Hojnadel/TD2_Altium/Proyecto/Datasheets/TFT 3.5/pantalla-tactil-tft-lcd-color-35-lector-sd.jpg

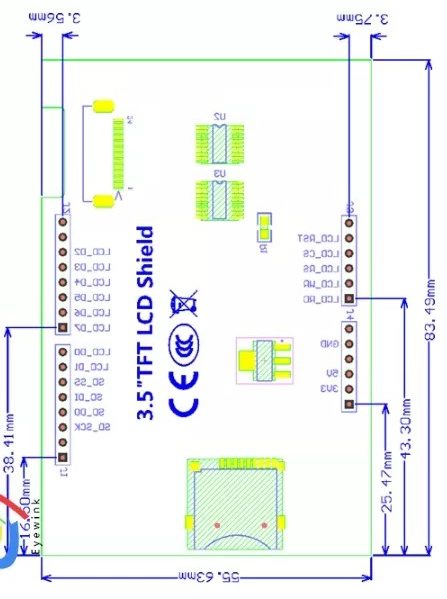
Proyecto/Datasheets/TFT 3.5/pantalla-tactil-tft-lcd-color-35-lector-sd.jpg
