Hojnadel/TD2_Altium/Proyecto/_Fuente Td2/Captura1.JPG

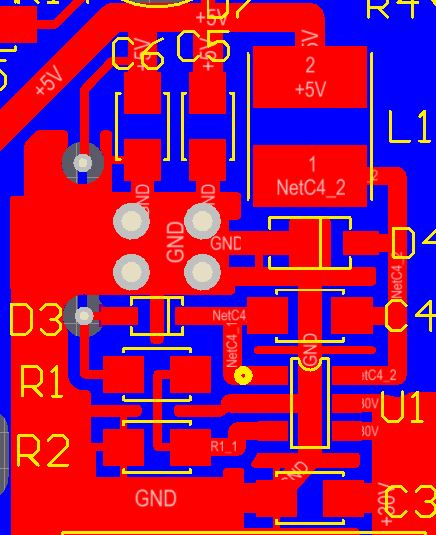
Proyecto/_Fuente Td2/Captura1.JPG
