Hojnadel/TD2_Altium/Proyecto/TDII_Proyecto_G5_Informe_Tecnico.pdf

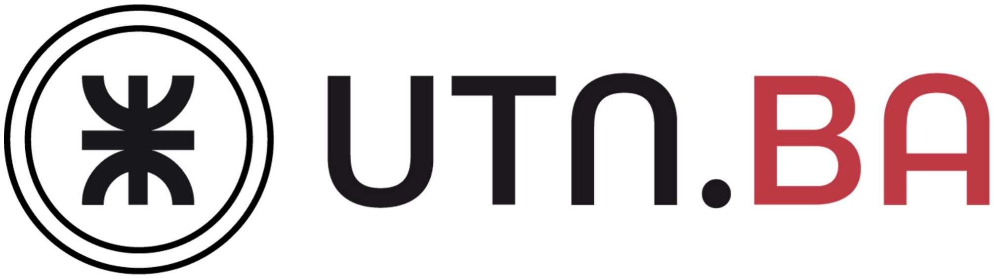
[picture p3: figure]

### Universidad Tecnologica Nacional ´

Facultad Regional Buenos Aires

Departamento de Electronica ´

### Tecnicas Digitales II ´

Proyecto:

## Analizador de Espectro de Audio

## Año 2018

### Grupo No 5:

Integrantes: De Rosa, Mauricio | 140.508-1
Hojnadel, Andrés | 154.563-2

### Salazar Ato, Benjamín Yahir 155.803-1

Soglio, Julián | 141.448-3

### Docentes: Ing. Alarcón, Juan Esteban Ing. Crivelli, Marcelo Alberto

Técnicas Digitales II - Curso: R4051

Técnicas Digitales II
Proyecto: Analizador de Espectro de Audio

Universidad Tecnológica Nacional Facultad Regional Buenos Aires

## Índice

1. Descripción del proyecto | 3
2. Diagrama en bloques | 3
3. Especificaciones técnicas | 4
4. Diagramas esquemáticos | 4
5. Lista de materiales (BOM) | 10
6. PCB: Render 3D | 12
7. Placa soldada | 12
8. Pantalla: ILI9341 | 13
9. Software | 13
9.2.3. Tarea de lectura del teclado: void vTask TecladoRead(void const *) . . . 15
9.2.4. Tarea de resolución del teclado: void vTask TecladoResolve(void const *) 16
10.Gabinete | 17
11.Referencias | 22
Informe Técnico | 2 | Grupo 5

## 1. Descripción del proyecto

El proyecto a diseñar consta de un analizador de espectro de audio el cual podrá adquirir señales ya sea a través su micrófono interno incorporado o cualquier otro dispositivo externo mediante la entrada de audio de 3.5mm para luego realizarles una transformada rápida de Fourier (FFT)[1] y mostrar por pantalla el espectro de la misma en forma continua o en barras de octava. Además cuenta con un conector extra como salida de audio para poder reproducir el audio en el caso de utilizar un dispositivo externo. El ancho de banda a analizar es será de 1Hz a 20kHz.

Internamente consta de cinco bloques: la fuente alimentación, la cual recibe a la entrada una tensión entre 9V y 12V y luego genera 5V y 3V 3 mediante dos fuentes switching; la etapa de adquisición y acondicionamiento de señal, formada por el conector de 3.5mm estereo y el micrófono para la adquisición, y un controlador automático de ganancia (AGC) para el acondicionamiento; un conversor analógico-digital (ADC PCM1802)[2] de 24 bits para realizar el muestreo; el microcontrolador (LPC1769)[3] encargado del procesamiento de la señal y comunicación de los periféricos; el display táctil por el cuál se mostrará la el espectro de la señal y que además funcionará como dispositivo de entrada para las configuraciones menores del dispositivo.

Como la alimentación es con fuente simple (no maneja tensiones negativas) en el acondicionamiento de señal se le agrega una tensión de offset de 2,5 V tal que pueda excursionar de manera simétrica entre 0 V y 5 V . Para ello, luego del levantamiento en continua, se utilizan amplificadores rail-to-rail para poder generar tensiones de salida de tensión similar a su alimentación.

## 2. Diagrama en bloques

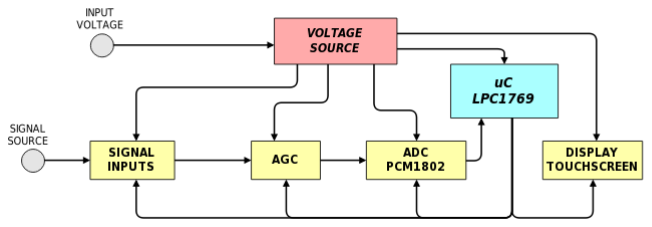
[picture p4: figure]

Figura 1: Diagrama en bloques

Informe Técnico | 3 | Grupo 5

## 3. Especificaciones técnicas

Tensión de alimentación: 9V ∼ 12V

Amplitud máxima de señal: 1,5Vpp

Ancho de banda: 20kHz

Display: TFT LCD Touchscreen 3.2”

## 4. Diagramas esquemáticos

Todos los diagramas esquemáticos del dispositivo y el diseño del PCB fue realizado mediante el software Altium[4].

### 4.1. Estructura jerárquica

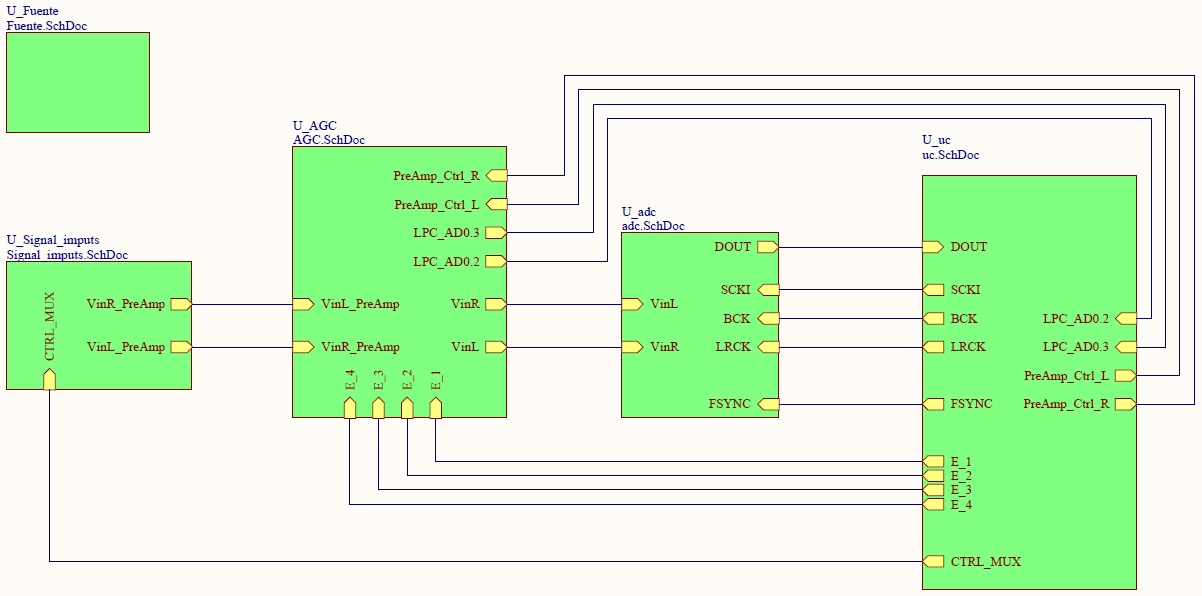
[picture p5: figure]

Figura 2: Estructura jerárquica

Informe Técnico | 4 | Grupo 5

### 4.2. Fuente de alimentación

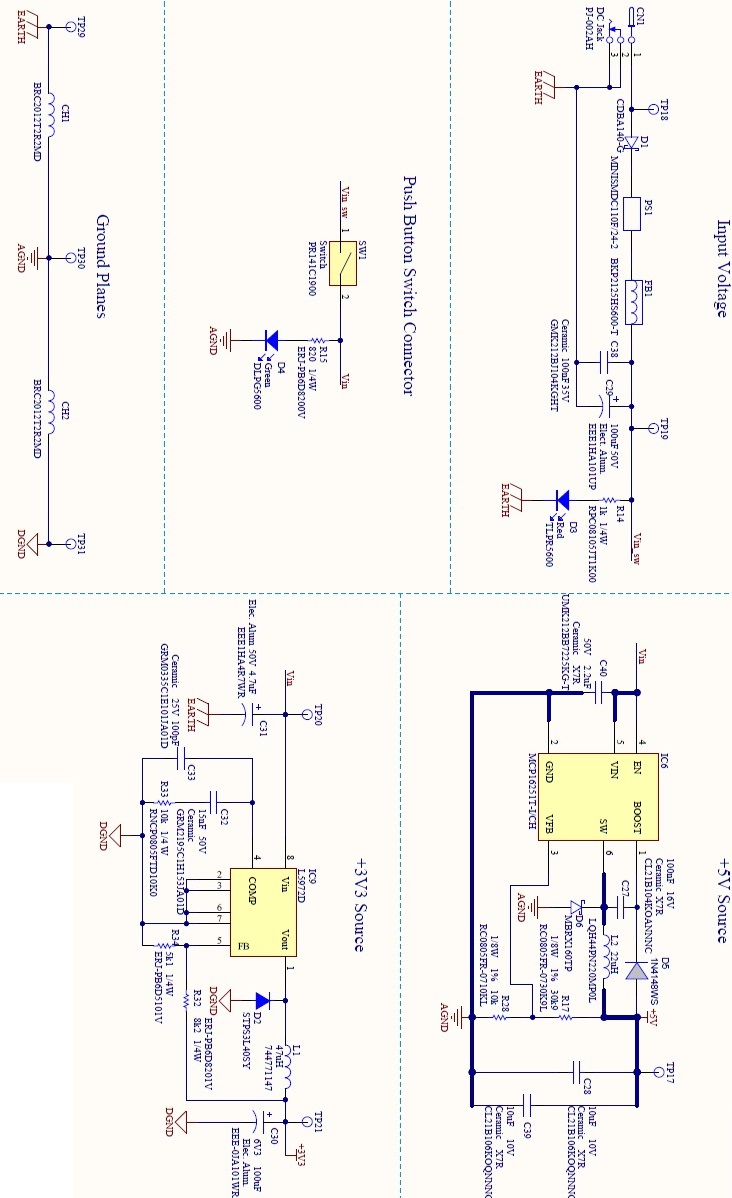
[picture p6: figure]

Figura 3: Esquemático de la fuente de alimentación

Informe Técnico | 5 | Grupo 5

### 4.3. Entrada de señal

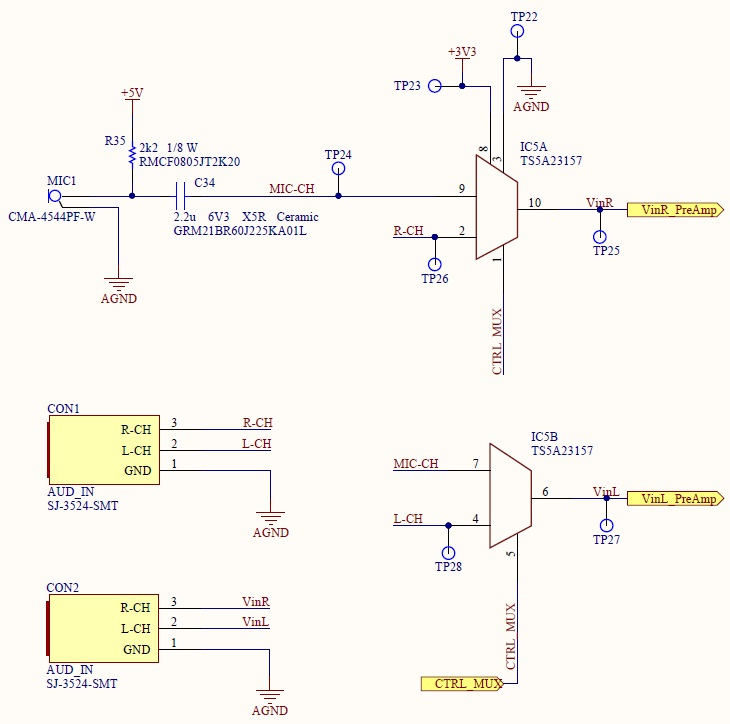
[picture p7: figure]

Figura 4: Esquemático de las entradas de señal

Informe Técnico | 6 | Grupo 5

### 4.4. Control Automático de Ganancia

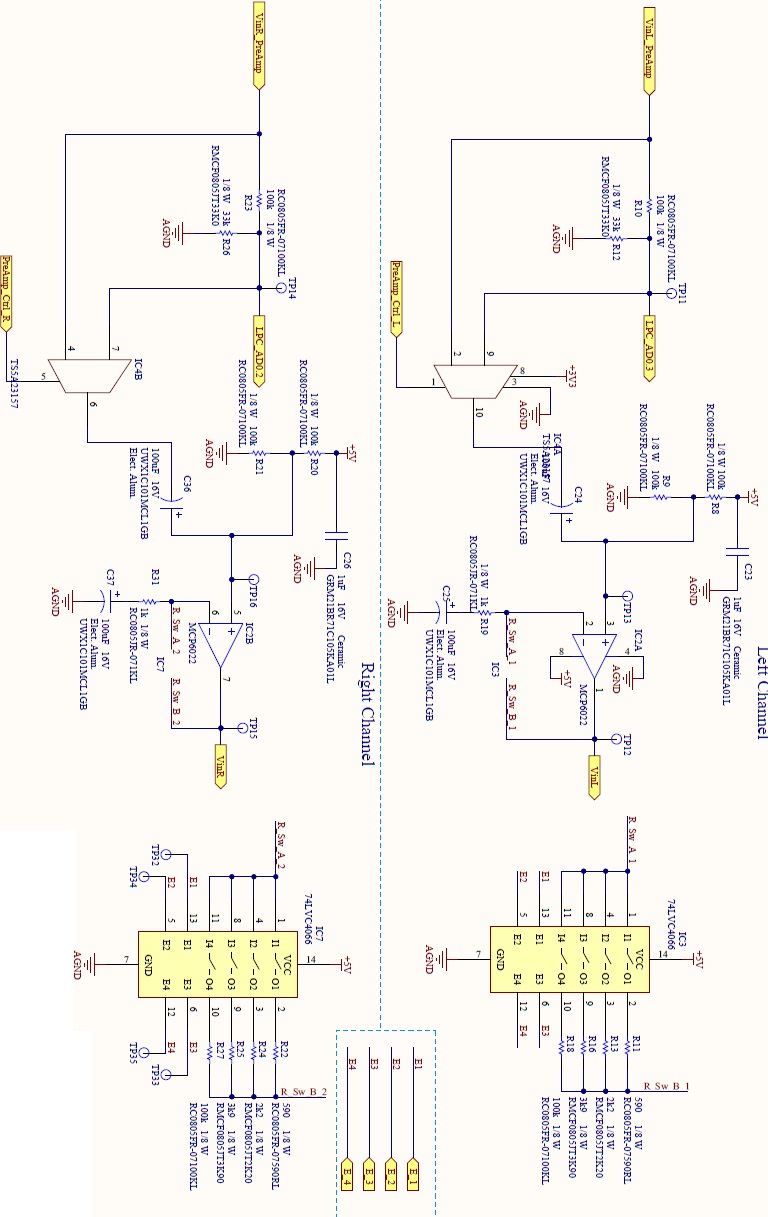
[picture p8: figure]

Figura 5: Esquemático del AGC

Informe Técnico | 7 | Grupo 5

### 4.5. ADC

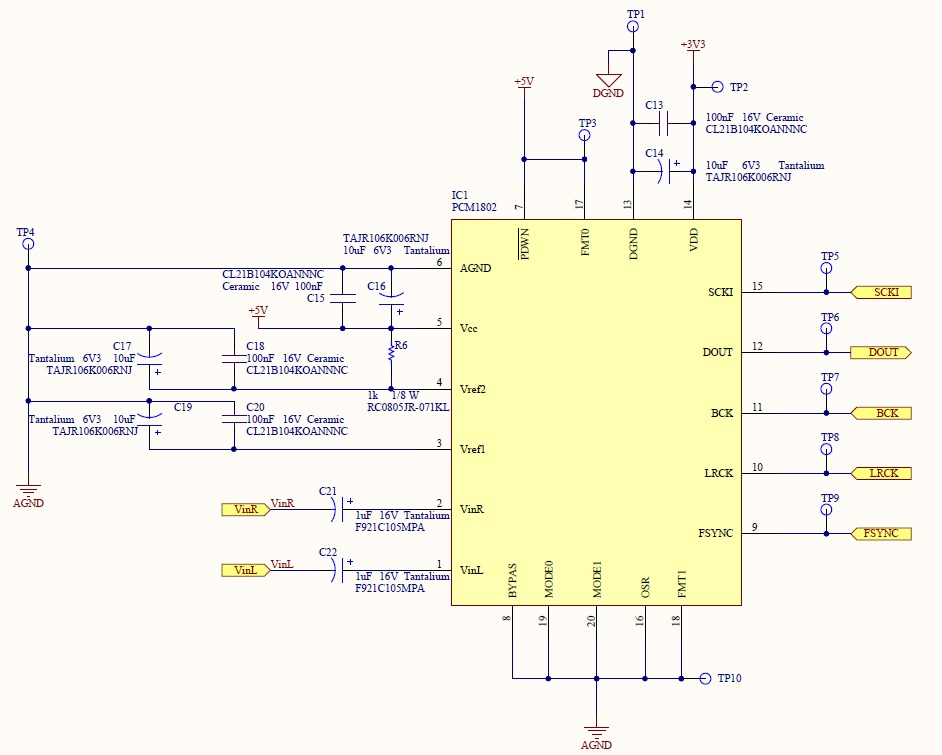
[picture p9: figure]

Figura 6: Esquemático del ADC

Informe Técnico | 8 | Grupo 5

### 4.6. µC

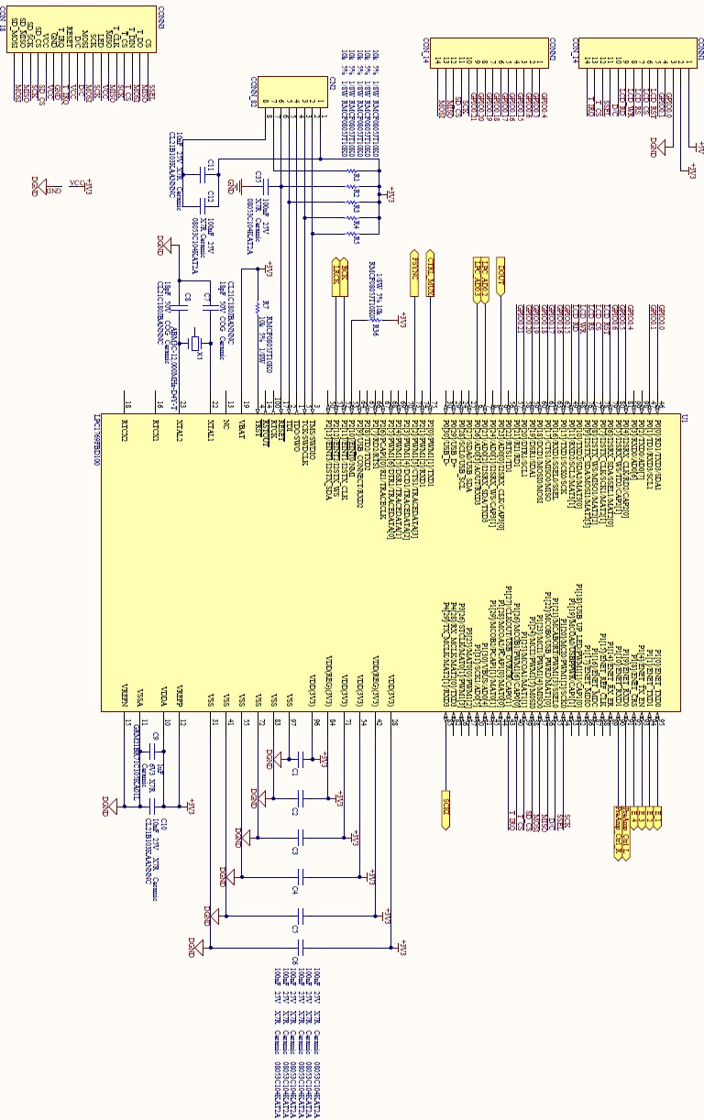
[picture p10: figure]

Figura 7: Esquemático del microcontrolador

Informe Técnico | 9 | Grupo 5

## 5. Lista de materiales (BOM)

### 5.1. Parte 1

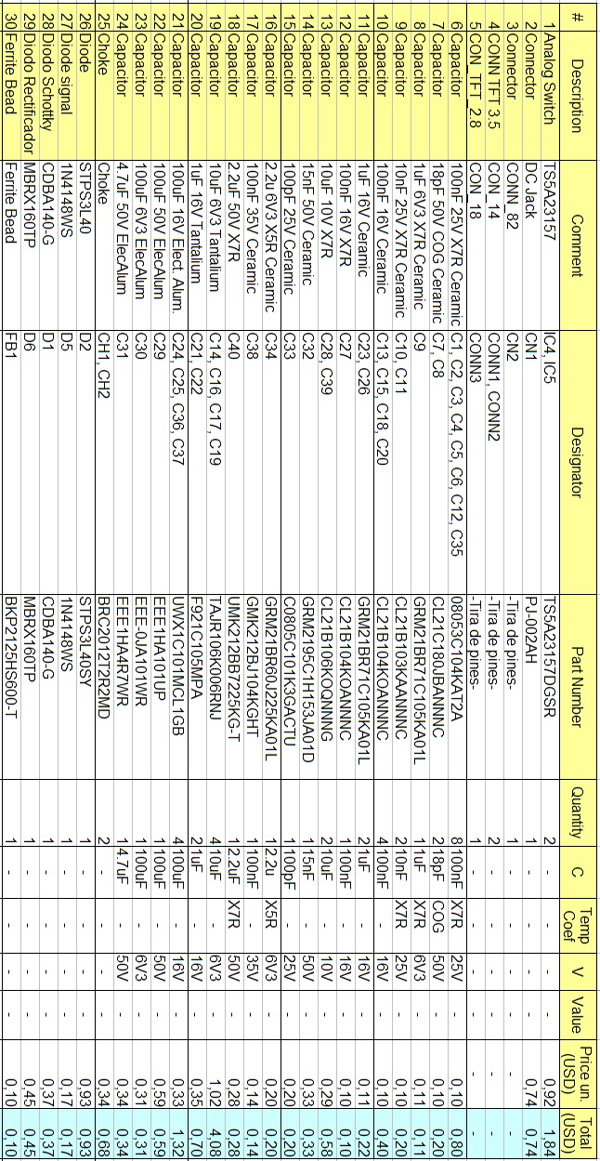
[picture p11: figure]

Informe Técnico | 10 | Grupo 5

### 5.2. Parte 2

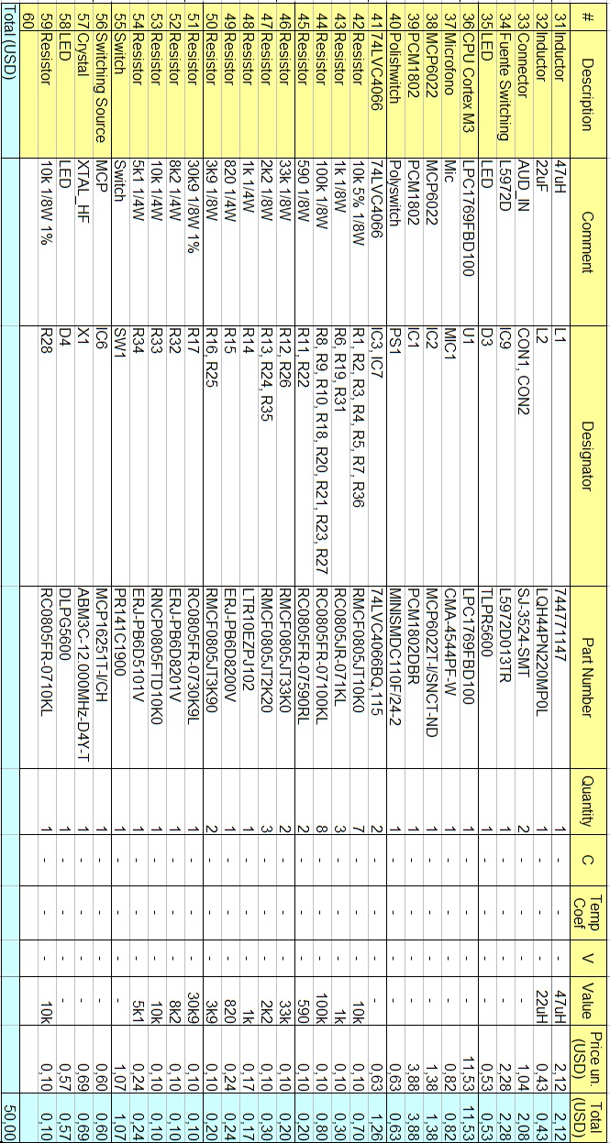
[picture p12: figure]

Informe Técnico | 11 | Grupo 5

## 6. PCB: Render 3D

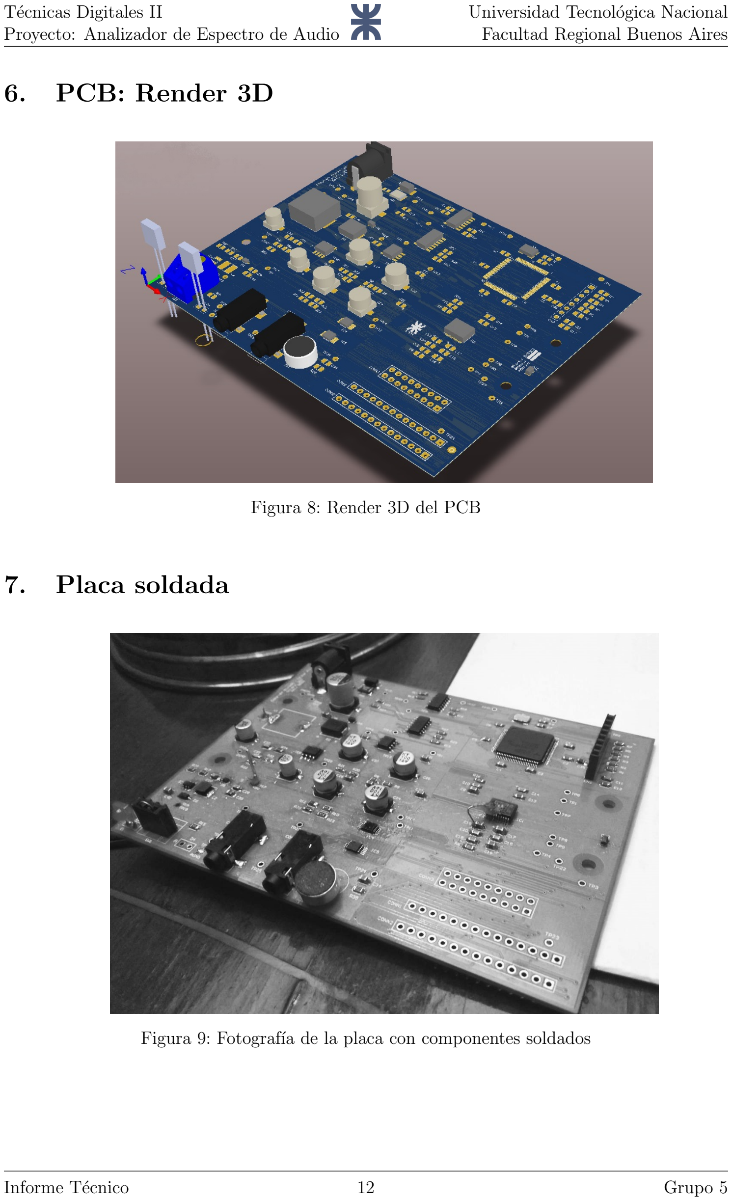
[picture p13: page 12]

Figura 8: Render 3D del PCB

## 7. Placa soldada

Figura 9: Fotografía de la placa con componentes soldados

Informe Técnico | 12 | Grupo 5

## 8. Pantalla: ILI9341

La pantalla utilizada es una pantalla TFT (Thin Film Transistor) de 240x320 píxeles RGB, modelo ILI9341[5]. Utiliza alimentación de 5V para manejar la iluminación de background y 3.3V para las señales de comunicación. Cuenta con 34 pines distribuidos en dos filas de 17 que se conectan al PCB mediante un bus plano.

La escritura en la pantalla puede realizarse mediante comunicación paralelo o SPI. Posee interacción táctil y un slot para tarjeta de memoria SD las cuales también se controlan mediante protocolo SPI.

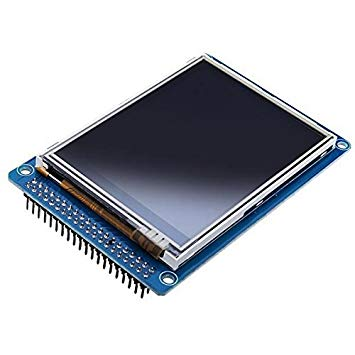
[picture p14: figure]

## 9. Software

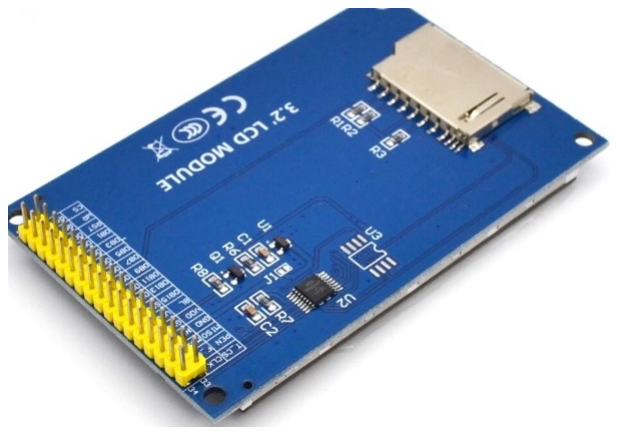
[picture p15: figure]

El software desarrollado para este dispositivo se ejecuta en el microcontrolador LPC-1769 de la familia ARM Cortex-M [8] (Cortex-M3). Del dispositivo se utilizan los periféricos de ADC (2 canales) para implementar un AGC (control automático de ganancia), el periférico de I2S como protocolo de comunicación entre el µC y el ADC externo, DMA para almacenar los datos convertidos por este ADC, el periférico de SPI para la comunicación del touchscreen y de la memoria SD.

El código fue desarrollado en lenguaje C mediante el entorno de desarrollo que proporciona la firma del µC: LPC-Expresso[6].

La lógica del programa es administrada por el sistema operativo en tiempo real para sistemas embebidos FreeRTOS[7].

Para el desarrollo fueron necesarias la biblioteca arm math de la CMSIS-DSP[9] para las operaciones relacionadas al procesamiento de la señal, y la biblioteca TFT ILI9341 para el manejo de la pantalla.

Informe Técnico | 13 | Grupo 5

### 9.1. Diagrama de flujo del programa

El dispositivo recibe una señal analógica estéreo la cual es convertida a formato digital mediante el ADC PCM-1802 a una frecuencia de muestreo de 32kHz y 32 bits por muestra. Los bits de la señal son mandados mediante protocolo I2C en formato Q1.31 y son almacenados en memoria utilizando DMA. Se disponen de un buffer de memoria dividido en dos mitades de manera de que cuando se completa la primer mitad, ésta se procesa y se siguen almacenando datos en la segunda mitad para luego repetir el proceso.

El procesamiento consta de la suma de ambos canales con su previo escalado, se aplica la ventana de muestreo definida por el usuario (rectangular, Hamming o Blackman) y luego se realiza el algoritmo de FFT. Una vez obtenido el módulo de la FFT, se la grafica en pantalla según el span de frecuencia definido también por el usuario.

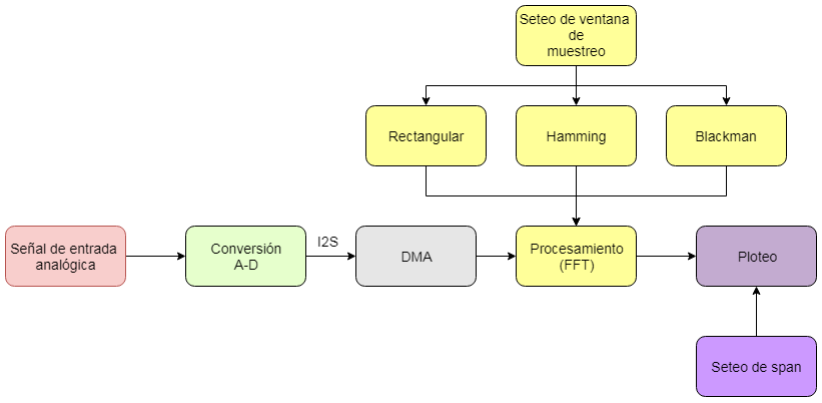
[picture p16: figure]

Figura 10: Diagrama de flujo del programa

### 9.2. Código

### 9.2.1. Programa Principal: int main(void)

i n t main ( v oid ){
HAL Init ( ) ;
Sy s temCl ock C on fi g ( ) ;

MX GPIO Init ( ) ;
MX DMA Init ( ) ;
MX I 2S 2 Ini t ( ) ;
MX I 2S 3 Ini t ( ) ;
MX SPI1 Init ( ) ;
MX ADC2 Init ( ) ;
MX ADC1 Init ( ) ;
i ni t m ai n ( ) ;

a r m r f f t f a s t i n i t f 3 2 (& si n t ,MUESTRAS) ; TM ILI9341 MPX axis ( ) ;

MX FREERTOS Init ( ) ;

o sK e r n el S t a r t ( ) ;

w hil e ( 1 ) {
}
}
Informe Técnico | 14 | Grupo 5

### 9.2.2. Inicialización del SO: void MX FREERTOS Init(void)

v oid MX FREERTOS Init ( v oid ) {

/∗ C re a te the semaphores ( s ) ∗/
/∗ d e f i n i t i o n and c r e a t i o n o f SemRead ∗/
osSemaphoreDe f ( SemRead ) ;
SemReadHandle = osSemaphoreCreate ( osSemaphore ( SemRead ) , 1 ) ;

/∗ d e f i n i t i o n and c r e a t i o n o f SemProc ∗/
osSemaphoreDe f ( SemProc ) ;
SemProcHandle = osSemaphoreCreate ( osSemaphore ( SemProc ) , 1 ) ;

/∗ d e f i n i t i o n and c r e a t i o n o f SemPlot ∗/
osSemaphoreDe f ( SemPlot ) ;
SemPlotHandle = osSemaphoreCreate ( osSemaphore ( SemPlot ) , 1 ) ;

/∗ C re a te the th re ad ( s ) ∗/
/∗ d e f i n i t i o n and c r e a t i o n o f d e f a ul tT a s k ∗/
osThreadDe f ( de f aul tT a s k , S t a r tD e f a ul tT a s k , o sP ri o ri t yN o rm al , 0 , 1 2 8 ) ; de f aul tT a s kH andle = osThreadCreate ( osThread ( d e f a ul tT a s k ) , NULL ) ;

/∗ d e f i n i t i o n and c r e a t i o n o f I2SRead ∗/
osThreadDe f ( I2SRead , vTask I2SRead , o sP ri o ri t yN o rm al , 0 , 1 2 8 ) ; I2SReadHandle = osThreadCreate ( osThread ( I2SRead ) , NULL ) ;

/∗ d e f i n i t i o n and c r e a t i o n o f Si gP r oc ∗/
osThreadDe f ( SigProc , vTask SigProc , o sP ri o ri tyBel owN o rm al , 0 , 1 2 8 ) ; SigP rocHandle = osThreadCreate ( osThread ( Si gP r oc ) , NULL ) ;

/∗ d e f i n i t i o n and c r e a t i o n o f Pl o t ∗/
osThreadDe f ( Plot , vTask Plot , o sP ri o ri t yL ow , 0 , 1 2 8 ) ; PlotHandle = osThreadCreate ( osThread ( Pl o t ) , NULL ) ;

/∗ d e f i n i t i o n and c r e a t i o n o f TecladoRead ∗/
osThreadDe f ( TecladoRead , vTask TecladoRead , o sP ri o ri t yN o rm al , 0 , 1 2 8 ) ; TecladoReadHandle = osThreadCreate ( osThread ( TecladoRead ) , NULL ) ;

/∗ d e f i n i t i o n and c r e a t i o n o f Tecl ad oRe s ol ve ∗/
osThreadDe f ( Tecl ad oRe s olve , vTa sk TecladoRe solve , o sP ri o ri t yN o rm al , 0 , 1 2 8 ); Tecl ad oRe s olveH andle = osThreadCreate ( osThread ( Tecl ad oRe s ol ve ) , NULL ) ;

/∗ C re a te the queue ( s ) ∗/
/∗ d e f i n i t i o n and c r e a t i o n o f QueueKey ∗/
osMessageQDef ( QueueKey , 1 , u i n t 8 t ) ;
QueueKeyHandle = o sMe s s a geC re a te ( osMessageQ ( QueueKey ) , 0 ) ;

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

### 9.2.3. Tarea de lectura del teclado: void vTask TecladoRead(void const *)

v oid vTask TecladoRead ( v oid c o n s t ∗){

3 | i f | ( ! HAL GPIO ReadPin ( SW2 GPIO Port , SW2 Pin ) )
xQueueOverwrite ( QueueKey , SW1 ) ;
e l s e i f ( ! HAL GPIO ReadPin ( SW1 GPIO Port , SW1 Pin ) ) xQueueOverwrite ( QueueKey , SW2 ) ;
e l s e i f ( ! HAL GPIO ReadPin ( SW3 GPIO Port , SW3 Pin ) ) xQueueOverwrite ( QueueKey , SW3 ) ;
e l s e i f ( ! HAL GPIO ReadPin ( SW4 GPIO Port , SW4 Pin ) ) xQueueOverwrite ( QueueKey , SW4 ) ;

}

Informe Técnico | 15 | Grupo 5

### 9.2.4. Tarea de resolución del teclado: void vTask TecladoResolve(void const *)

1 v oid vT a sk Tecl ad oRe s olve ( v oid c o n s t ∗){

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

6
7 | w hil e ( 1 ) {

8
9 | xQueueReceive ( QueueKey , &t e cl a , portMAX TICK ) ;

10
11 | swi t c h ( t e c l a ){
12 | c a s e SW1:
13 | span = span + SCREEN WIDTH − FFT OFFSET X;
14 | i f ( span == RANGO 871 1160 + SCREEN WIDTH − FFT OFFSET X)
15 | span = 0 ;
16 | TM ILI9341 MPX axis setup ( span ) ;
17 | xQueueOverwrite ( QueueSpan , &span ) ;
18 | break ;

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

27
28 | c a s e SW3:
29 | break ;

30
31 | c a s e SW4:
32 | break ;

33
34 | }//End Switch

35
36 | t e c l a = NO TECLA;
37 | }
38 | }

### 9.2.5. Tarea de procesamiento: void vTask SigProc(void const *)

1 | v oid vT a sk Si gP r oc ( v oid c o n s t ∗ argument )
2 | {
3 | u i n t 8 t window type = RECTANGULAR;
4 | u i n t 3 2 t inde x ;
5 | f l o a t 3 2 t max=0;

6
7 xSemaphoreTake ( SemProcHandle , portMAX DELAY ) ;

8
9 | f o r ( ; ; ) {
10 | xSemaphoreTake ( SemProcHandle , portMAX DELAY ) ;

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

16
17 | xQueuePeek (QueueWindow , &window type , NO WAIT ) ;

18
19 | swi t c h ( window type ){
20 | c a s e (RECTANGULAR) :
21 | break ;
22 | c a s e (BLACKMAN) :
23 | a rm mul t f 3 2 ( bu f fe r sum a , blackman window , bu f fe r sum a , MUESTRAS) ;
24 | break ;
25 | c a s e (HAMMING) :
26 | a rm mul t f 3 2 ( bu f fe r sum a , hamming window , bu f fe r sum a , MUESTRAS) ;
27 | break ;
28 | }
Informe Técnico | 16 | Grupo 5

a r m r f f t f a s t f 3 2 (& si n t , bu f fe r sum a , t ran s fo rmada , 0 ) ;

arm max f32 ( t ran s fo rmada , MUESTRAS, &max, &inde x ) ;

i f (max<FFT SATURATION){

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

arm cmplx mag f32 ( t ran s fo rmada , t r a n s f o rm a d a fi n al ,MUESTRAS) ;
}

xSemaphoreGive ( SemPlotHandle ) ;

}
}

## 10. Gabinete

El diseño del cabinete fue realizado mediante la herramienta FreeCAD[10], la cual permite importar los modelos 3D del PCB diseñado en Altium, como así también de la pantalla a utilizar.

### 10.1. Render 3D

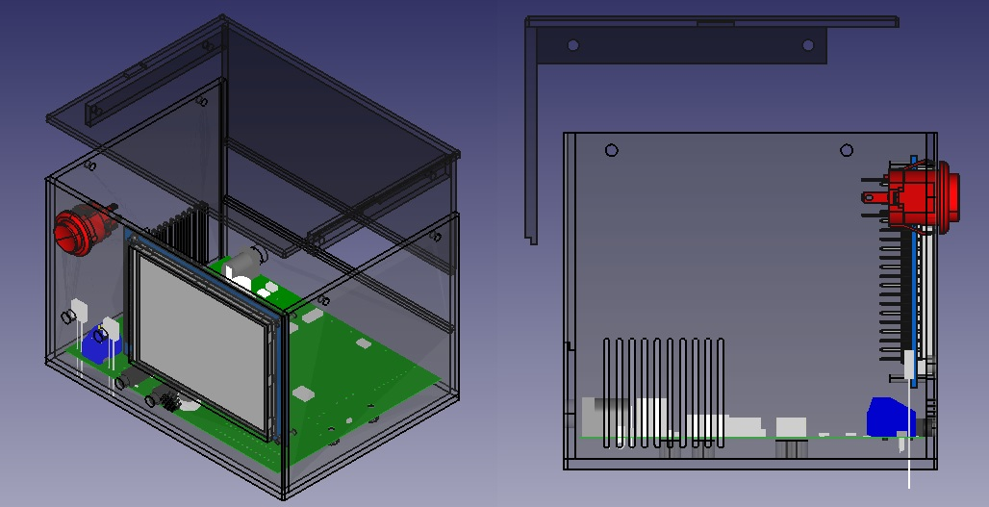
[picture p17: figure]

Figura 11: Vista 3D del gabinete

Informe Técnico | 17 | Grupo 5

### 10.2. Planos

### 10.2.1. Gabinete: dimensiones generales

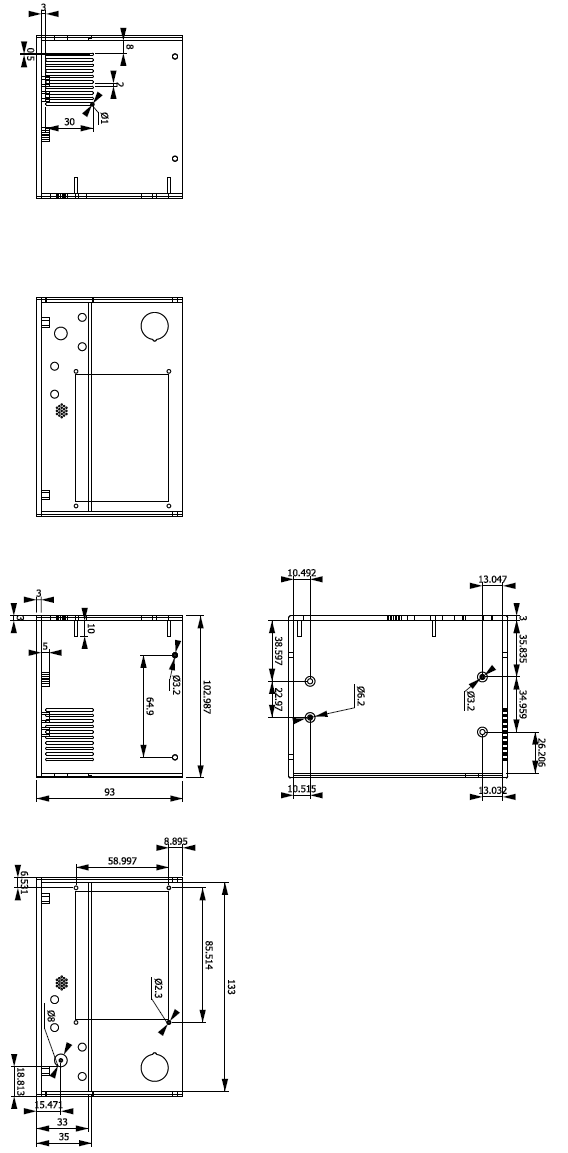
[picture p18: figure]

Informe Técnico | 18 | Grupo 5

### 10.2.2. Gabinete: detalle de vista frontal

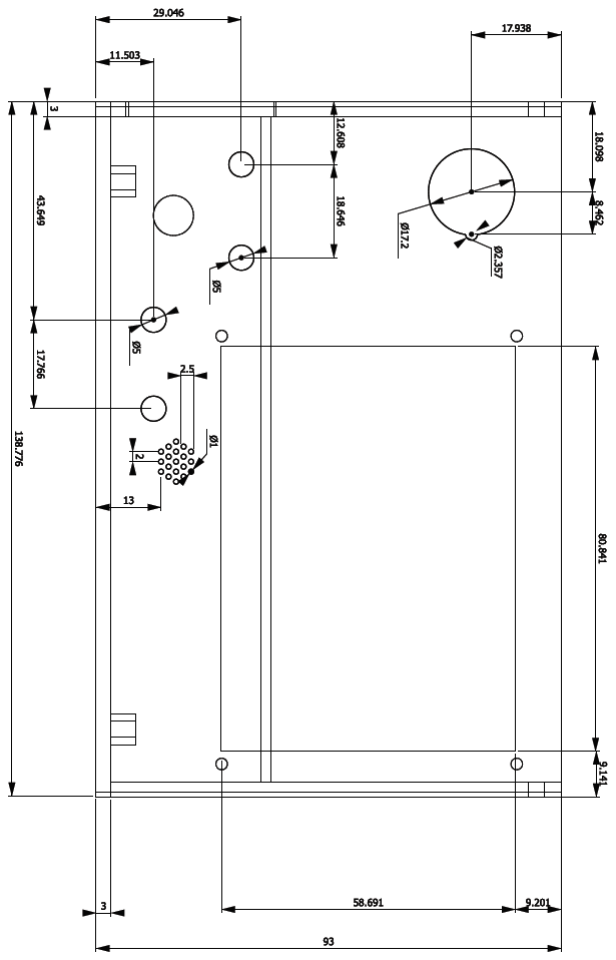
[picture p19: figure]

Informe Técnico | 19 | Grupo 5

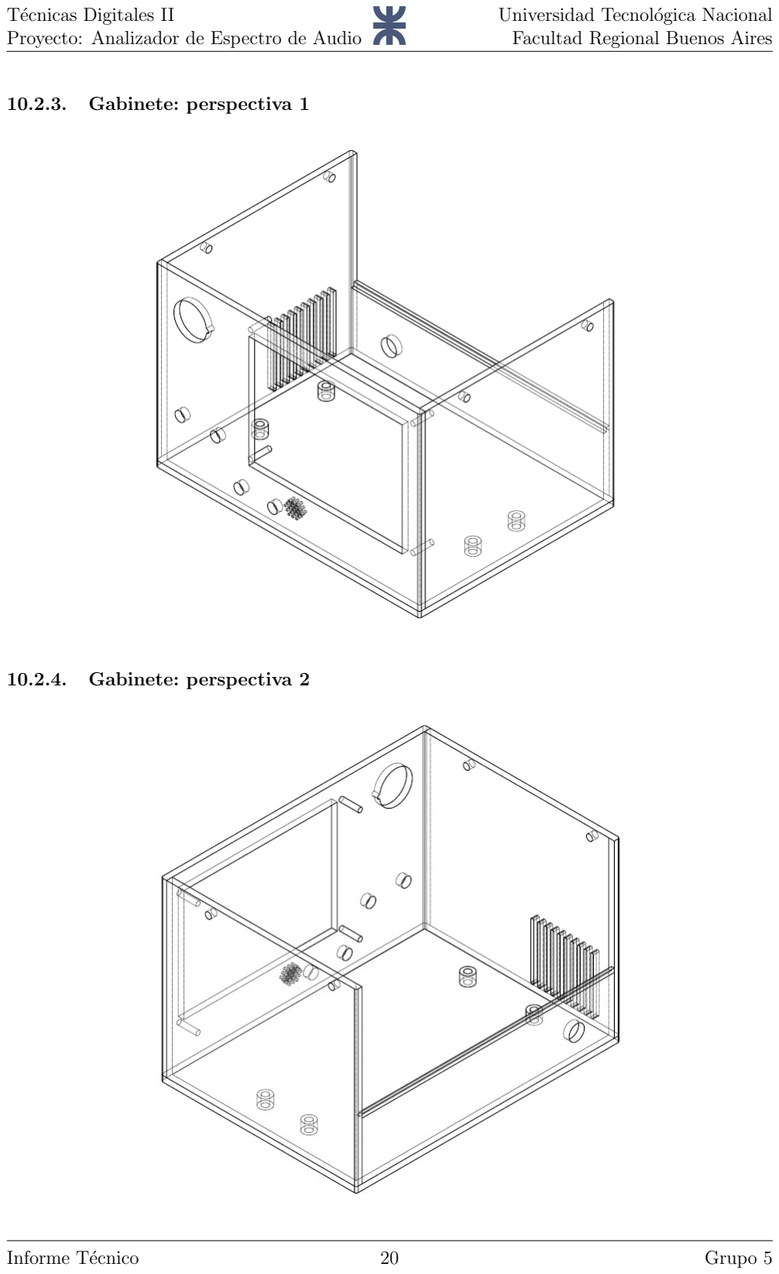
[picture p20: page 20]

### 10.2.3. Gabinete: perspectiva 1

### 10.2.4. Gabinete: perspectiva 2

Informe Técnico | 20 | Grupo 5

### 10.2.5. Pieza superior: dimensiones generales

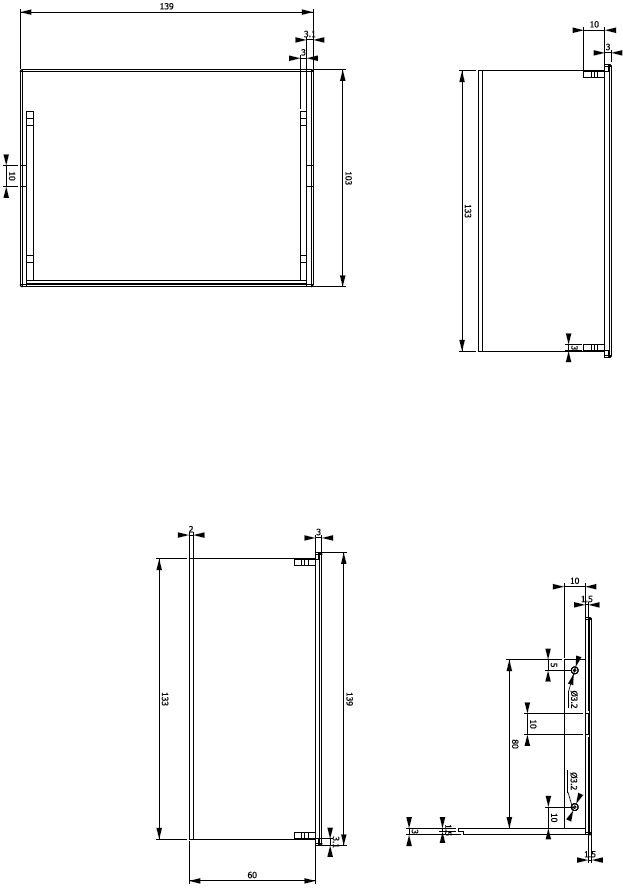
[picture p21: figure]

Informe Técnico | 21 | Grupo 5

### 10.2.6. Pieza superior: perspectiva

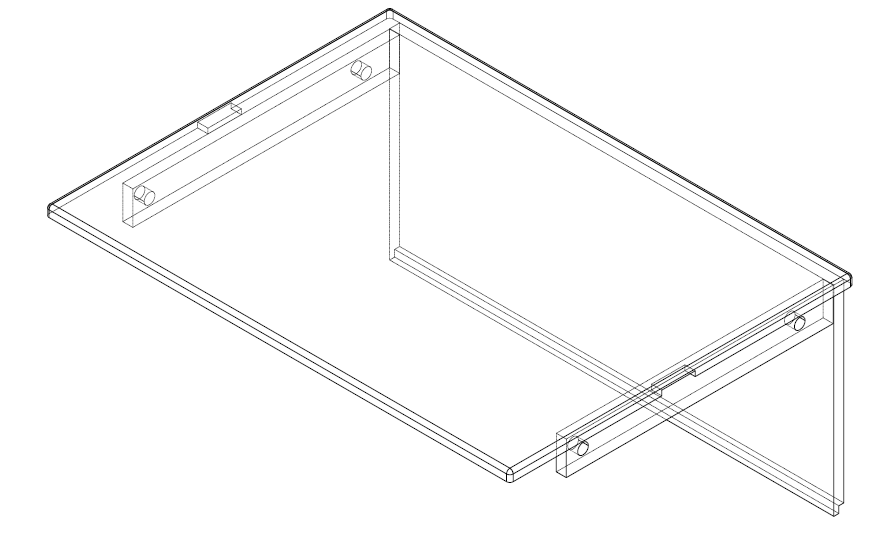
[picture p22: figure]

## Referencias

[1] FFT (Fast Fourier Transform). https://en.wikipedia.org/wiki/Fast Fourier transform.
[2] PCM 1802. https://www.ti.com/lit/ds/symlink/pcm1802.pdf
[3] NXP LPC-1769. https://www.nxp.com/docs/en/data-sheet/LPC1769 68 67 66 65 64 63.pdf
[4] Altium. https://www.altium.com/es
[5] ILI9341 TFT Touchscreen 3.2”. https://cdn-shop.adafruit.com/datasheets/ILI9341.pdf
[6] LPCExpresso. | https://www.nxp.com/products/processors-and-microcontrollers/arm-
based-processors-and-mcus/lpc-cortex-m-mcus/lpc1100-cortex-m0-plus-m0/lpcxpresso-idev8.2.2:LPCXPRESSO
[7] FreeRtos. https://www.freertos.org/
[8] ARM Cortex-M. https://www.arm.com/products/silicon-ip-cpu
[9] CMSIS-DSP. http://www.keil.com/pack/doc/CMSIS/DSP/html/index.html
[10] FreeCAD. https://www.freecadweb.org/
Informe Técnico | 22 | Grupo 5
