Hojnadel/TD2_Altium/Analizador_de_Espectro_(SdR).pdf

Universidad Tecnologica Nacional ´

Facultad Regional Buenos Aires

Departamento de Electronica ´

Sistemas de Representacion

´

Trabajo Practico N ´
o 3:

### Analizador de Espectro de Audio

### Año 2017

Autor: Hojnadel, Andrés

E-Mail: ahojnadel@est.frba.utn.edu.ar

Docentes: Ing. Ridolfi, Pablo Oscar Sr. Del Conte, Franco

Fecha de entrega: 11 de noviembre de 2017

Sistemas de Representación - Curso: R1032

Sistemas de Representación
TP No 3: Analizador de Espectro de Audio

Universidad Tecnológica Nacional Facultad Regional Buenos Aires

### Índice

1. Descripción del proyecto | 3
2. Diagrama en bloques | 3
3. Especificaciones técnicas | 4
4. Diagramas esquemáticos | 4
5. Lista de materiales (BOM) | 10
6. PCB: Render 3D | 12
7. PCB Checklist | 12
8. Gabinete | 14
Curso R1032 | 2 | Hojnadel, Andrés

### 1. Descripción del proyecto

El proyecto a diseñar consta de un analizador de espectro de audio el cual podrá adquirir señales ya sea a través su micrófono interno incorporado o cual-quier otro dispositivo externo mediante la entrada de audio de 3.5mm para luego realizarles una transformada rápida de Fourier (FFT) y mostrar por pantalla el espectro de la misma en forma continua o en barras de octava. Además cuenta con un conector extra como salida de audio para poder reproducir el audio en el caso de utilizar un dispositivo externo. El ancho de banda a analizar es será de 1Hz a 20kHz.

Internamente consta de cinco bloques: la fuente alimentación, la cual recibe a la entrada una tensión entre 9V y 12V y luego genera 5V y 3V 3 mediante dos fuentes switching; la etapa de adquisición y acondicionamiento de señal, formada por el conector de 3.5mm estereo y el micrófono para la adquisición, y un controlador automático de ganancia (AGC) para el acondicionamiento; un conversor analógico-digital (ADC PCM1802) de 24 bits para realizar el mues-treo; el microcontrolador (LPC1769) encargado del procesamiento de la señal y comunicación de los periféricos; el display táctil por el cuál se mostrará la el espectro de la señal y que además funcionará como dispositivo de entrada para las configuraciones menores del dispositivo.

### 2. Diagrama en bloques


Figura 1: Diagrama en bloques

Curso R1032 | 3 | Hojnadel, Andrés

### 3. Especificaciones técnicas

Tensión de alimentación: 9V ∼ 12

Amplitud máxima de señal: 1,5Vpp

Ancho de banda: 20kHz

Display: TFT LCD Touchscreen 3.2”

### 4. Diagramas esquemáticos

### 4.1. Estructura jerárquica


Figura 2: Estructura jerárquica

Curso R1032 | 4 | Hojnadel, Andrés

### 4.2. Fuente de alimentación


Figura 3: Esquemático de la fuente de alimentación

Curso R1032 | 5 | Hojnadel, Andrés

### 4.3. Entrada de señal


Figura 4: Esquemático de las entradas de señal

Curso R1032 | 6 | Hojnadel, Andrés

### 4.4. Control Automático de Ganancia


Figura 5: Esquemático del AGC

Curso R1032 | 7 | Hojnadel, Andrés

### 4.5. ADC


Figura 6: Esquemático del ADC

Curso R1032 | 8 | Hojnadel, Andrés

### 4.6. µC


Figura 7: Esquemático del microcontrolador

Curso R1032 | 9 | Hojnadel, Andrés

### 5. Lista de materiales (BOM)

### 5.1. Parte 1


Curso R1032 | 10 | Hojnadel, Andrés

### 5.2. Parte 2


Curso R1032 | 11 | Hojnadel, Andrés

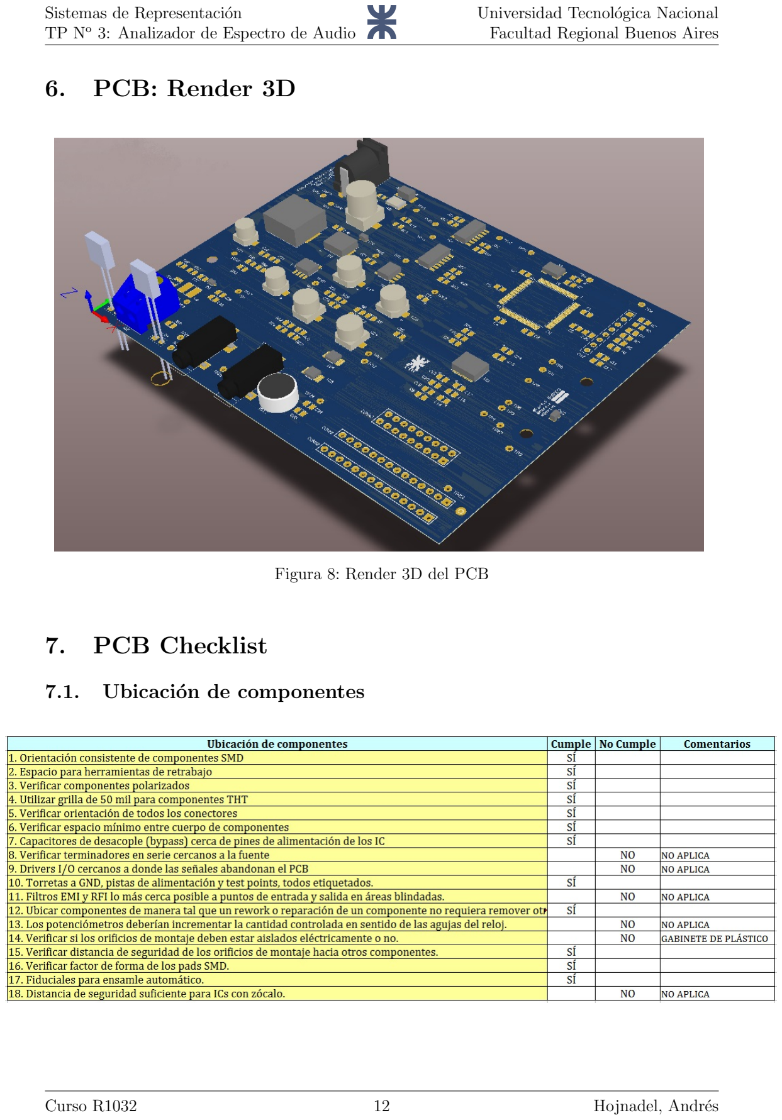
[picture p23: page 12]

### 6. PCB: Render 3D

Figura 8: Render 3D del PCB

### 7. PCB Checklist

### 7.1. Ubicación de componentes

Curso R1032 | 12 | Hojnadel, Andrés

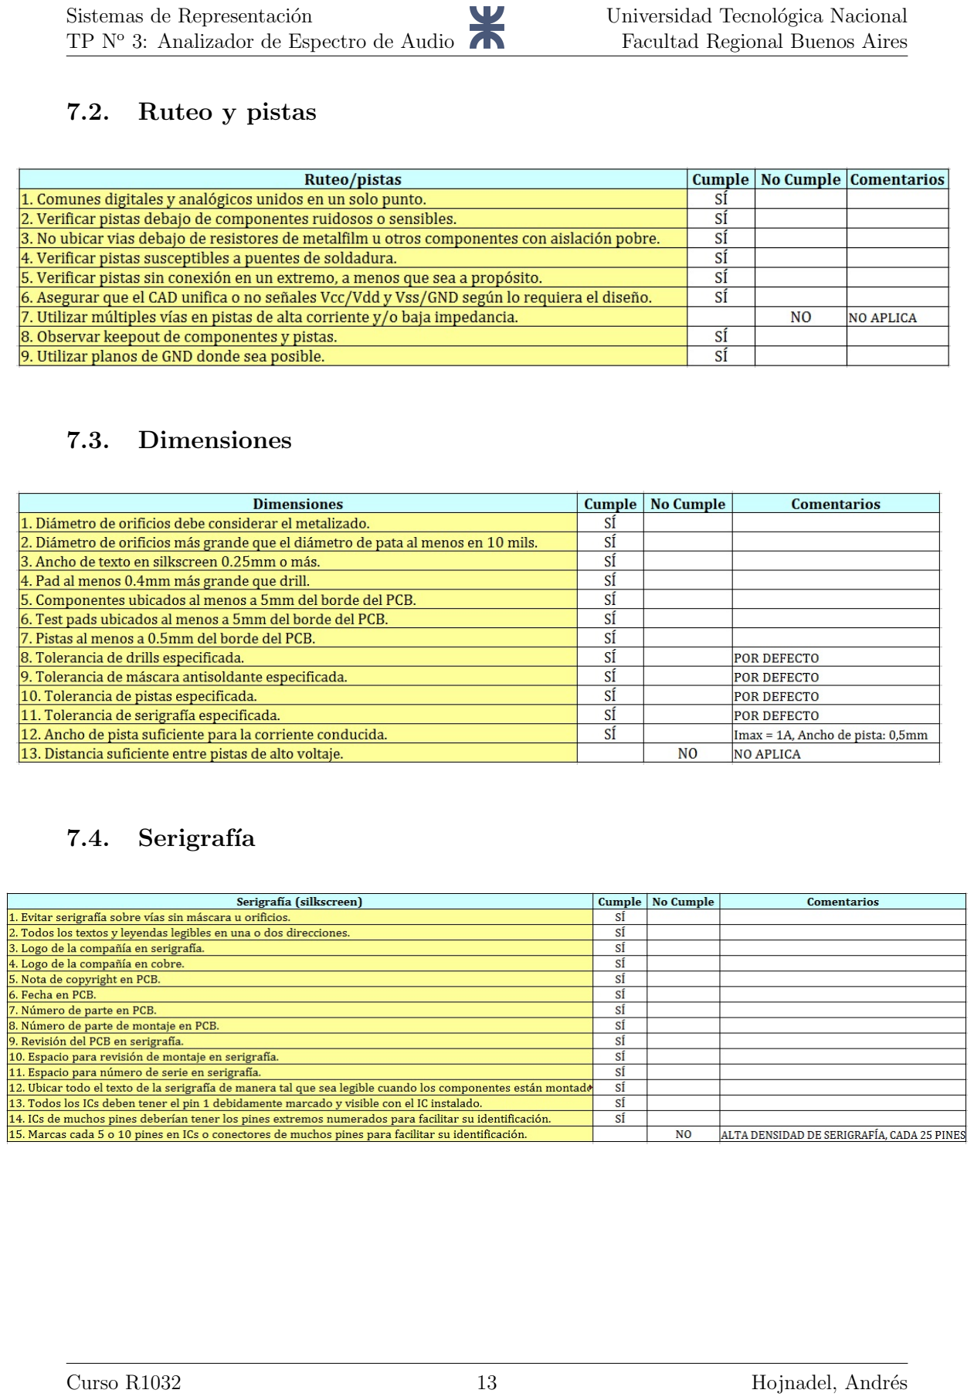
[picture p24: page 13]

### 7.2. Ruteo y pistas

### 7.3. Dimensiones

### 7.4. Serigrafía

Curso R1032 | 13 | Hojnadel, Andrés

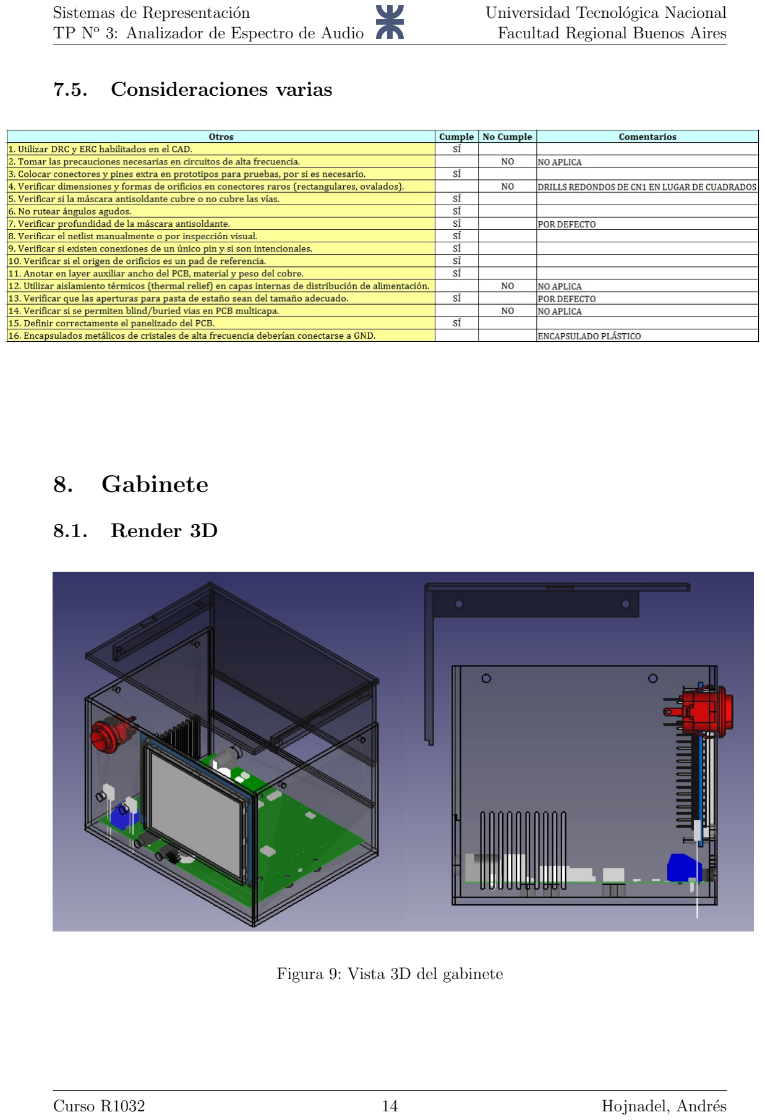
[picture p25: page 14]

### 7.5. Consideraciones varias

### 8. Gabinete

### 8.1. Render 3D

Figura 9: Vista 3D del gabinete

Curso R1032 | 14 | Hojnadel, Andrés

### 8.2. Planos

### 8.2.1. Gabinete: dimensiones generales

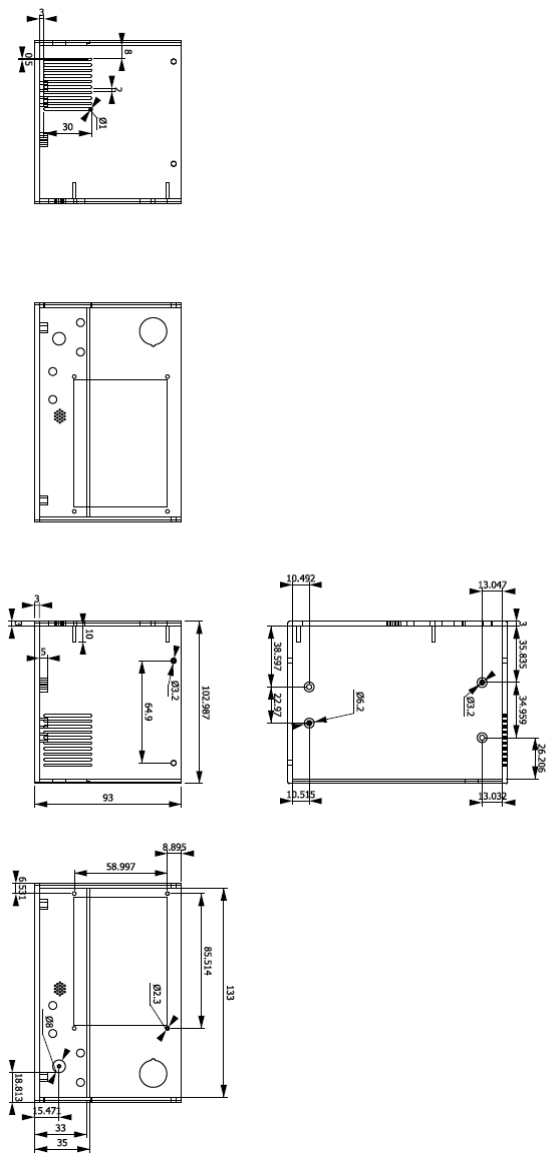
[picture p26: figure]

Curso R1032 | 15 | Hojnadel, Andrés

### 8.2.2. Gabinete: detalle de vista frontal


Curso R1032 | 16 | Hojnadel, Andrés

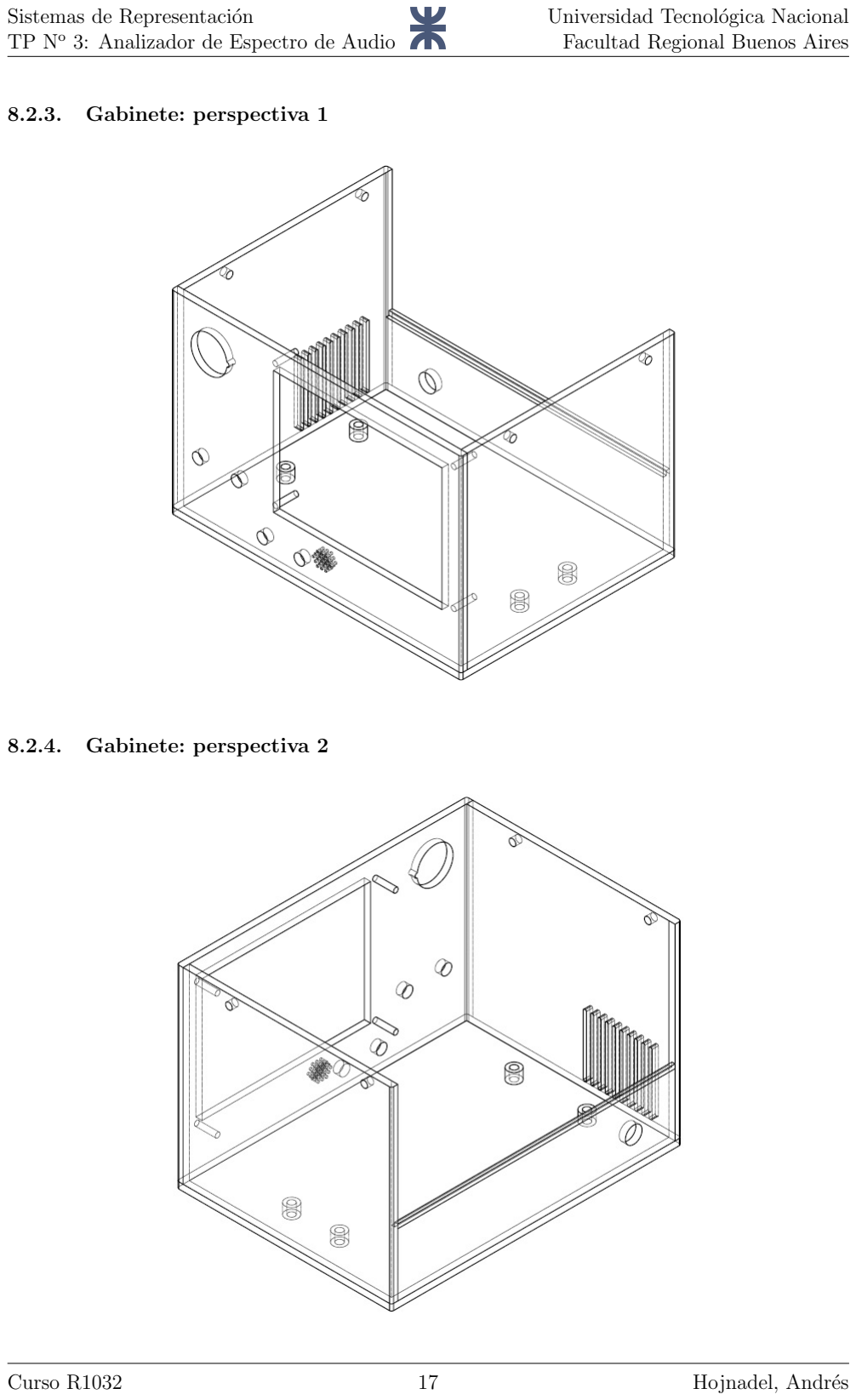
[picture p27: page 17]

### 8.2.3. Gabinete: perspectiva 1

### 8.2.4. Gabinete: perspectiva 2

Curso R1032 | 17 | Hojnadel, Andrés

### 8.2.5. Pieza superior: dimensiones generales


Curso R1032 | 18 | Hojnadel, Andrés

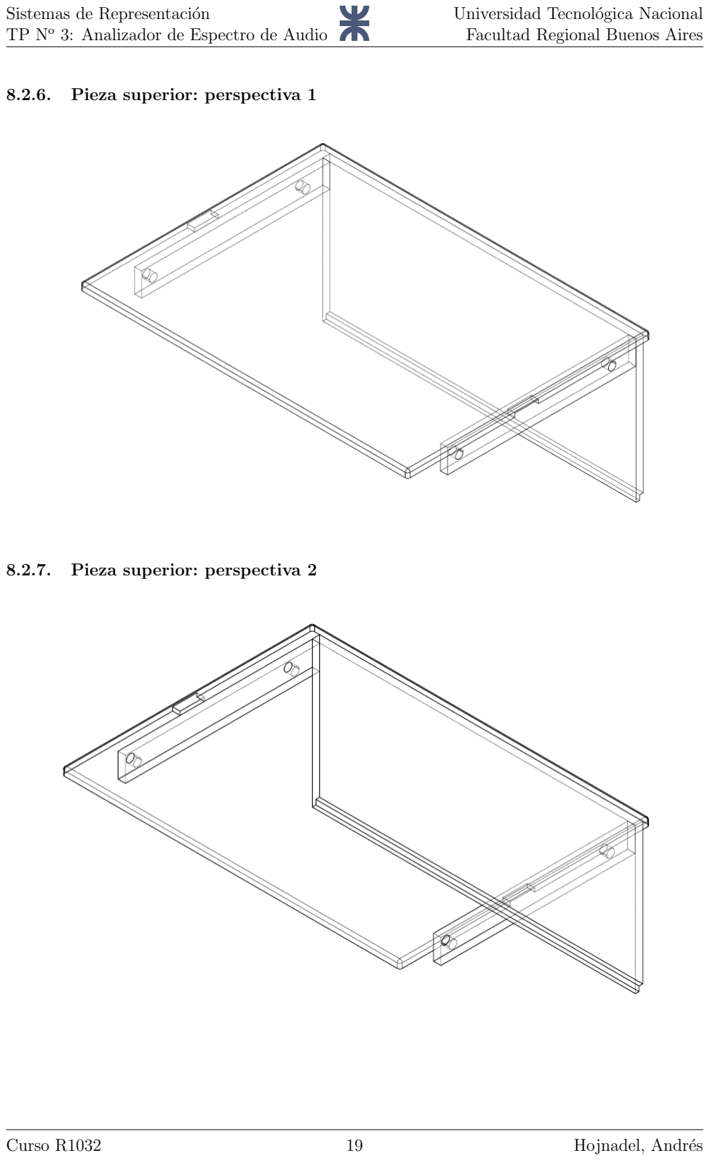
[picture p28: page 19]

### 8.2.6. Pieza superior: perspectiva 1

### 8.2.7. Pieza superior: perspectiva 2

Curso R1032 | 19 | Hojnadel, Andrés
