Hojnadel/TD2_Altium/Proyecto/Datasheets/TFT 3.5/3.5inch_Arduino_ILI9481_IPS_V3.0/STM32 Demo_STM32F103RCT6/STM32 IO模拟代码接线说明.txt

/****************************************************************************************************
//=========================================电源接线================================================//
//5V接DC 5V电源
//GND接地
//=======================================液晶屏数据线接线==========================================//
//本模块默认数据总线类型为8位并行模式
//8位模式接线：8位模式ILI9481模块接低8位总线，即:
//液晶屏LCD_D0对应单片机PB0
//液晶屏LCD_D1对应单片机PB1
//液晶屏LCD_D2对应单片机PB2
//液晶屏LCD_D3对应单片机PB3
//液晶屏LCD_D4对应单片机PB4
//液晶屏LCD_D5对应单片机PB5
//液晶屏LCD_D6对应单片机PB6
//液晶屏LCD_D7对应单片机PB7
//=======================================液晶屏控制线接线==========================================//
//LCD_RST	接PC5	//复位信号
//LCD_CS	接PC9	//片选信号
//LCD_RS	接PC8	//寄存器/数据选择信号
//LCD_WR	接PC7	//写信号
//LCD_RD	接PC6	//读信号
//=========================================触摸屏触接线=========================================//
//本模块触摸测试需连接外部XPT2046触摸采样芯片，所以本程序不进行触摸测试。
//不使用触摸或者模块本身不带触摸，则可不连接
**************************************************************************************************/
