Hojnadel/TD2_Altium/Proyecto/_Fuente Td2/Captura2.JPG

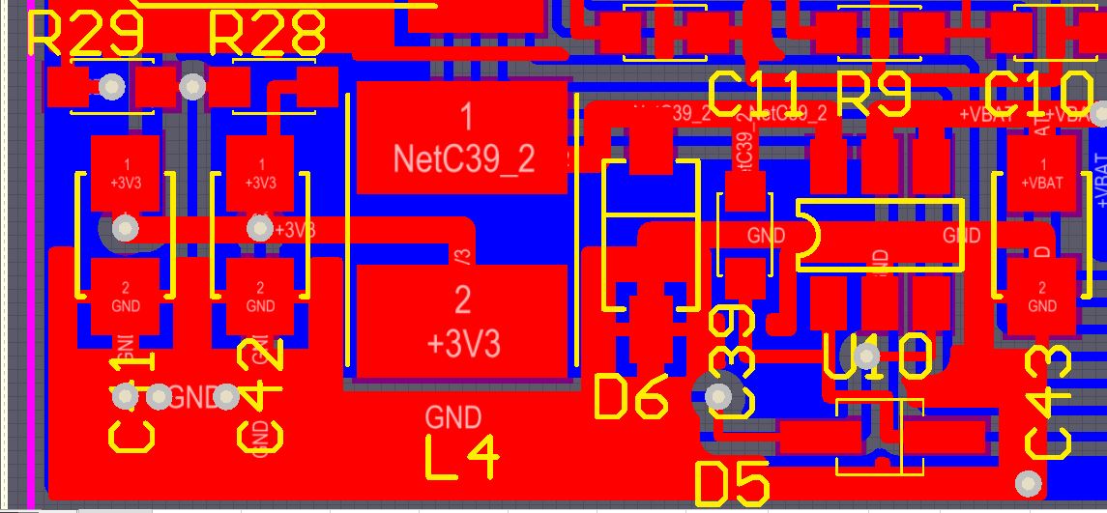
Proyecto/_Fuente Td2/Captura2.JPG
