Hojnadel/TD2_Altium/Proyecto/Datasheets/TFT 3.5/3.5inch_Arduino_ILI9481_V2.1/3.5inch_Arduino_ILI9481_Touch_V2.1/Module Size/size.PNG

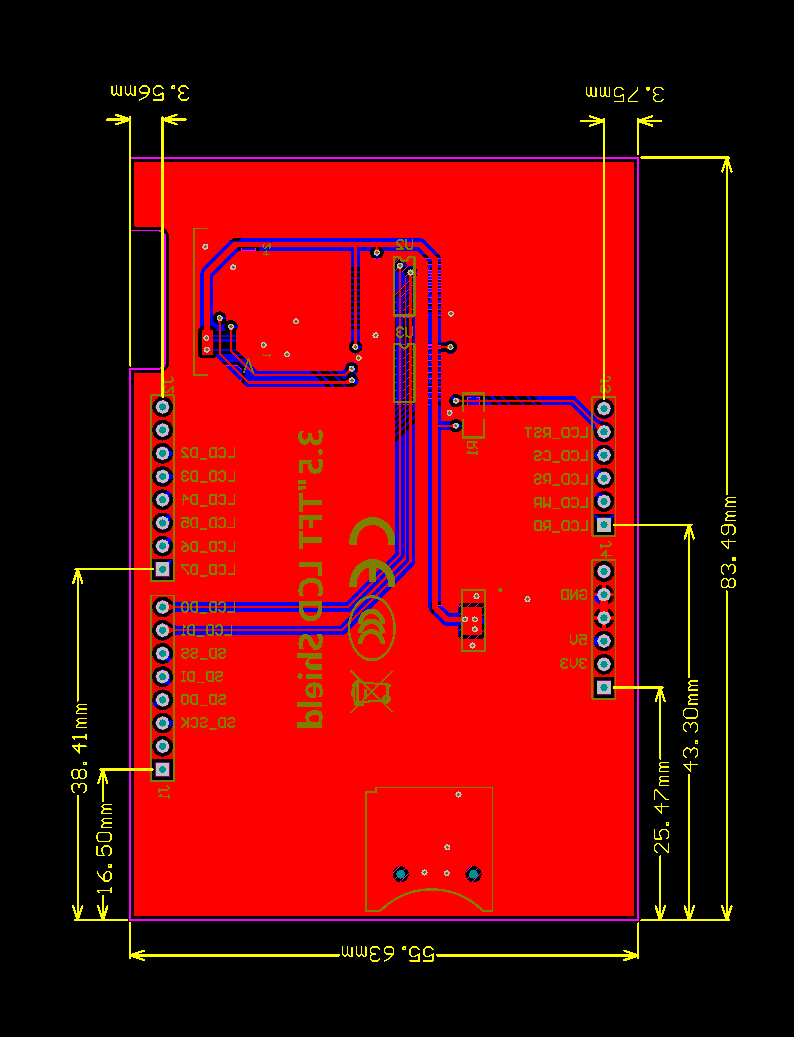
Proyecto/Datasheets/TFT 3.5/3.5inch_Arduino_ILI9481_V2.1/3.5inch_Arduino_ILI9481_Touch_V2.1/Module Size/size.PNG
