Hojnadel/TD2_Altium/Proyecto/Analizador_de_espectro/Project Outputs for Analizador_de_espectro/Analizador_de_espectro.csv

C | Comment | Description | Designator | Part Number | Quantity | Temp Coef | Tolerance | V | Value | Footprint | Temp. Coef.
 | TS5A23157 | Analog Switch | IC4, IC5 | TS5A23157 | 2 |  |  |  |  | TSSOP50P490X110-10N
 | DC Jack | Connector | CN1 | PJ-002AH | 1 |  |  |  |  | Jack_PJ002A
 | CONN_82 |  | CN2 |  | 1 |  |  |  |  | HDR_M_08P_0.1
 | CON_14 | CONN TFT 3.5 | CONN1, CONN2 |  | 2 |  |  |  |  | 1x14x2.54 Pin Header TH V
 | CON_18 | CON_TFT_2.8 | CONN3 |  | 1 |  |  |  |  | 2x9x2.54 Pin Header TH V
100nF | 100nF 25V X7R Ceramic | Capacitor | C1, C2, C3, C4, C5, C6, C12, C35 | 08053C104KAT2A | 8 | X7R |  | 25V |  | C_0805
18pF | 18pF 50V COG Ceramic | Capacitor | C7, C8 | CL21C180JBANNNC | 2 | COG |  | 50V |  | C_0805
1uF | 1uF 6V3 X7R Ceramic | Capacitor | C9 | GRM21BR71C105KA01L | 1 | X7R |  | 6V3 |  | C_0805
10nF | 10nF 25V X7R Ceramic | Capacitor | C10, C11 | CL21B103KAANNNC | 2 | X7R |  | 25V |  | C_0805
100nF | 100nF 16V Ceramic | Capacitor | C13, C15, C18, C20 | CL21B104KOANNNC | 4 |  |  | 16V |  | C_0805
1uF | 1uF 16V Ceramic | Capacitor | C23, C26 | GRM21BR71C105KA01L | 2 |  |  | 16V |  | C_0805
100nF | 100nF 16V X7R | Capacitor | C27 | CL21B104KOANNNC | 1 |  |  | 16V |  | C_0805
10uF | 10uF 10V X7R | Capacitor | C28, C39 | CL21B106KOQNNNG | 2 |  |  | 10V |  | C_0805
15nF | 15nF 50V Ceramic | Capacitor | C32 | GRM2195C1H153JA01D | 1 |  |  | 50V |  | C_0805
100pF | 100pF 25V Ceramic | Capacitor | C33 | GRM0335C1E101JA01D | 1 |  |  | 25V |  | C_0805
2.2u | 2.2u 6V3 X5R Ceramic | Capacitor | C34 | GRM21BR60J225KA01L | 1 | X5R |  | 6V3 |  | C_0805
100nF | 100nF 35V Ceramic | Capacitor | C38 | GMK212BJ104KGHT | 1 |  |  | 35V |  | C_0805
2.2uF | 2.2uF 50V X7R | Capacitor | C40 | UMK212BB7225KG-T | 1 |  |  | 50V |  | C_0805 | X7R
10uF | 10uF 6V3 Tantalium | Capacitor | C14, C16, C17, C19 | TAJR106K006RNJ | 4 |  |  | 6V3 |  | C_0805_pol
1uF | 1uF 16V Tantalium | Capacitor | C21, C22 | F921C105MPA | 2 |  |  | 16V |  | C_0805_pol
100uF | 100uF 16V Elect. Alum. | Capacitor | C24, C25, C36, C37 | UWX1C101MCL1GB | 4 |  |  | 16V |  | C_AE7066X54M
100uF | 100uF 50V ElecAlum | Capacitor | C29 | EEE1HA101UP | 1 |  |  | 50V |  | C_AE10083X105M
100uF | 100uF 6V3 ElecAlum | Capacitor | C30 | EEE-0JA101WR | 1 |  |  | 6V3 |  | C_AE6553X54M
4.7uF | 4.7uF 50V ElecAlum | Capacitor | C31 | EEE1HA4R7WR | 1 |  |  | 50V |  | C_AE6553X54M
 | Choke | Choke | CH1, CH2 | BRC2012T2R2MD | 2 |  |  |  |  | I_CHOQUE_DFN
 | STPS3L40 | Diode | D2 | STPS3L40SY | 1 |  |  |  |  | D_M6959X25N
 | 1N4148WS | Diode signal | D5 | 1N4148WS | 1 |  |  |  |  | 1N4148WS
 | CDBA140-G | Diodo Schottky | D1 | CDBA140-G | 1 |  |  |  |  | D_DO-214AC_Schottky
 | MBRX160TP |  | D6 | MBRX160TP | 1 |  |  |  |  | SOD_123
 | Ferrite Bead | Ferrite Bead | FB1 | BKP2125HS600-T | 1 |  |  |  |  | Ferrite_bead
 | 47uH | Inductor | L1 | 744771147 | 1 |  |  |  | 47uH | I_P128122X60N
 | LQH44PN220MP0L | Inductor | L2 |  | 1 |  |  |  | 22uH | VLCF5028
 | AUD_IN |  | CON1, CON2 | SJ-3524-SMT | 2 |  |  |  |  | AUDIO_JACK 3.5mm SMD
 | L5972D | Fuente Switching | IC9 | L5972D013TR | 1 |  |  |  |  | SO8
 | LED | LED | D3, D4 | TLPR5600, DLPG5600 | 2 |  |  |  |  | Led_TH
 | LPC1769FBD100 | CPU Cortex M3 | U1 | LPC1769FBD100 | 1 |  |  |  |  | LQFP100
 | Mic | Microfono | MIC1 | CMA-4544PF-W | 1 |  |  |  |  | MIC_CMA-4544PF-W
 | MCP6022 | MCP6022 | IC2 |  | 1 |  |  |  |  | SOIC_D8
 | PCM1802 | PCM1802 | IC1 | PCM1802DBR | 1 |  |  |  |  | SSOP_DB20
 | Polyswitch | Polishwitch | PS1 | MINISMDC110F/24-2 | 1 |  |  |  |  | POLISWITCH_1
 | 74LVC4066 | 74LVC4066 | IC3, IC7 | 74LVC4066BQ,115 | 2 |  |  |  |  | SO14
 | 10k 5% 1/8W | Resistor | R1, R2, R3, R4, R5, R7, R36 | RMCF0805JT10K0 | 7 |  | 5% |  | 10k | R_0805
 | 1k 1/8W | Resistor | R6, R19, R31 | RC0805JR-071KL | 3 |  |  |  | 1k | R_0805
 | 100k 1/8W | Resistor | R8, R9, R10, R18, R20, R21, R23, R27 | RC0805FR-07100KL | 8 |  |  |  | 100k | R_0805
 | 590 1/8W | Resistor | R11, R22 | RC0805FR-07590RL | 2 |  |  |  | 590 | R_0805
 | 33k 1/8W | Resistor | R12, R26 | RMCF0805JT33K0 | 2 |  |  |  | 33k | R_0805
 | 2k2 1/8W | Resistor | R13, R24, R35 | RMCF0805JT2K20 | 3 |  |  |  | 2k2 | R_0805
 | Res1 | Resistor | R14, R15 | RPC08105JT1K00, ERJ-PB6D8200V | 2 |  | [NoValue], 5% |  | 1k, 820 | R_0805
 | 3k9 1/8W | Resistor | R16, R25 | RMCF0805JT3K90 | 2 |  |  |  | 3k9 | R_0805
 | 30k9 1% | Resistor | R17, R28 | RC0805FR-0730K9L, RC0805FR-0710KL | 2 |  | 1% |  | 30k9, 10k | R_0805
 | 8k2 1/4W | Resistor | R32 | ERJ-PB6D8201V | 1 |  |  |  | 8k2 | R_0805
 | 10k 1/4W | Resistor | R33 | RNCP0805FTD10K0 | 1 |  |  |  | 10k | R_0805
 | 5k1 1/4W | Resistor | R34 | ERJ-PB6D5101V | 1 |  |  |  | 5k1 | R_0805
 | Switch | Switch | SW1 | PR141C1900 | 1 |  |  |  |  | BORNERA_2X5MM
 | MCP | Switching Source | IC6 |  | 1 |  |  |  |  | SOT23_6P
 | TP | Test Point | TP1, TP2, TP3, TP4, TP5, TP6, TP7, TP8, TP9, TP10, TP11, TP12, TP13, TP14, TP15, TP16, TP17, TP18, TP19, TP20, TP21, TP22, TP23, TP24, TP25, TP26, TP27, TP28, TP29, TP30, TP31, TP32, TP33, TP34, TP35 |  | 35 |  |  |  |  | TP
 | XTAL_HF | Crystal | X1 | ABM3C-12.000MHz-D4Y-T | 1 |  |  |  |  | ABMC_XTAL
