Hojnadel/TD2_Altium/Proyecto/Analizador_de_espectro/STEP/User Library-35RASMT4BHNTRX.step

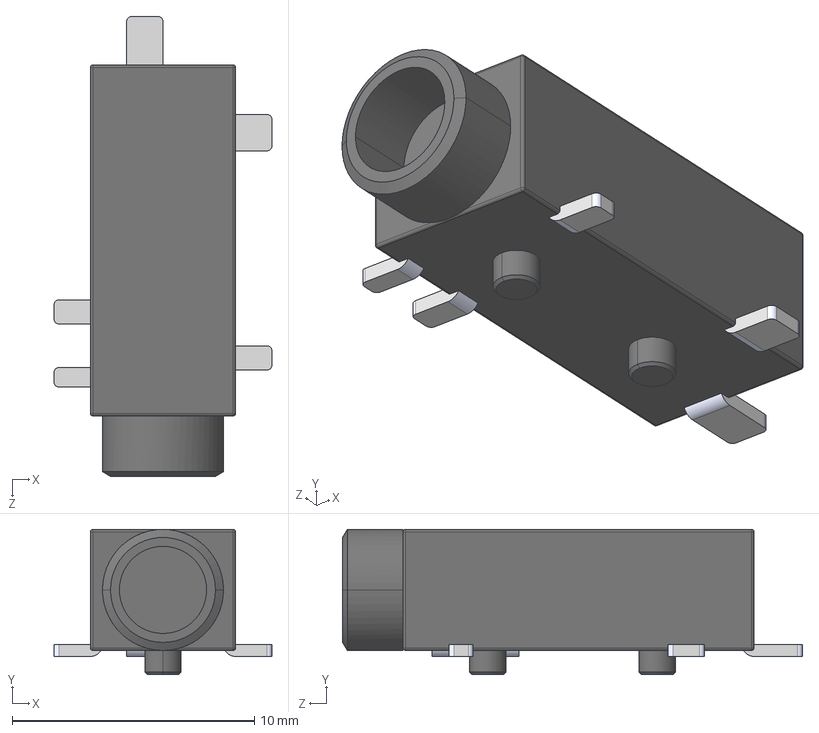
[picture p31: CAD file, 2017-10-12]
Proyecto/Analizador_de_espectro/STEP/User Library-35RASMT4BHNTRX.step
9.00 x 6.00 x 19.0 mm
