Hojnadel/TD2_Altium/Proyecto/Analizador_de_espectro/STEP/User Library-Bornera2.STEP

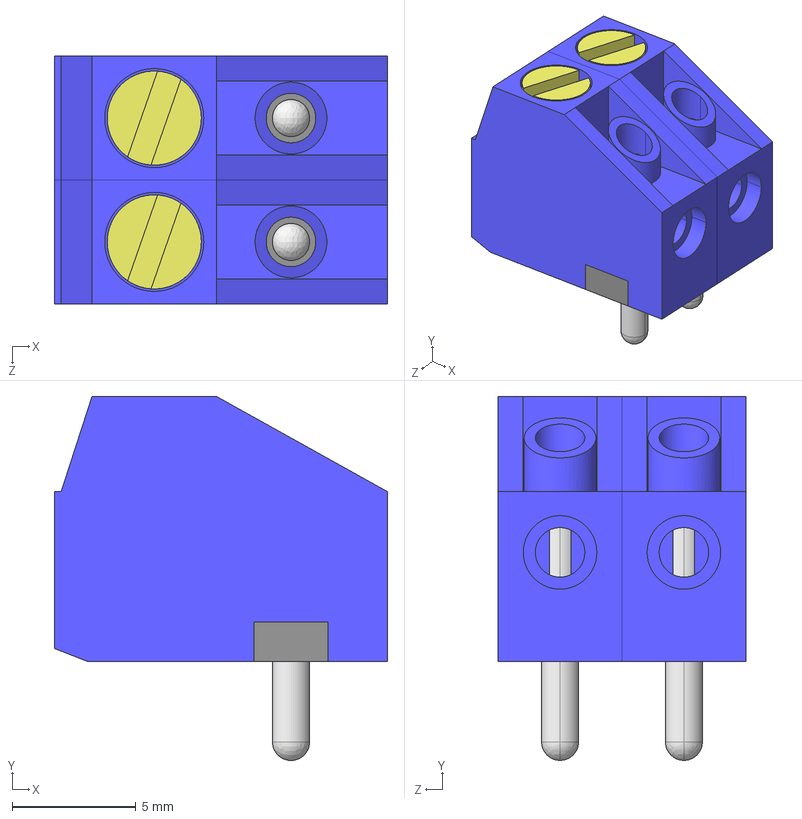
[picture p32: CAD file, 2017-10-12]
Proyecto/Analizador_de_espectro/STEP/User Library-Bornera2.STEP
13.5 x 14.7 x 10.0 mm
User Library-Bornera2_Base1 x 2
User Library-Bornera2_Base_base x 2
User Library-Bornera2_Pin x 2
User Library-Bornera2_Tornillo x 2
User Library-Bornera2_Prisionero x 2
