Hojnadel/TD2_Altium/Proyecto/Analizador_de_espectro/STEP/CMA-4544PF-W.stp

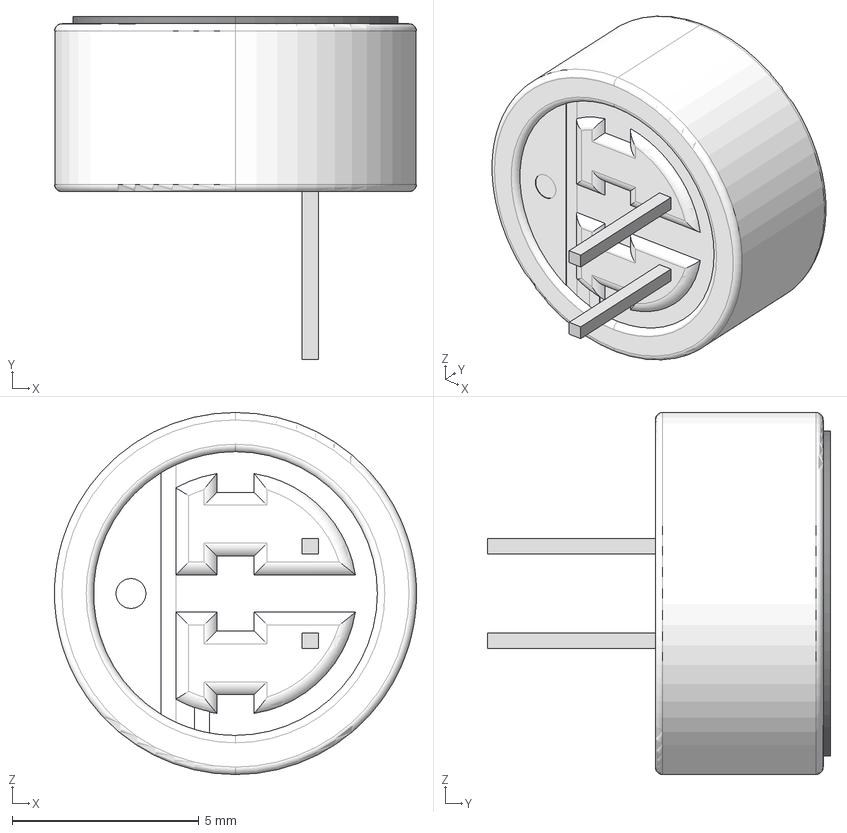
[picture p33: CAD file, 2017-10-12]
Proyecto/Analizador_de_espectro/STEP/CMA-4544PF-W.stp
9.70 x 9.20 x 9.70 mm
