Hojnadel/TD2_Altium/Proyecto/Analizador_de_espectro/STEP/PJ-002A.stp

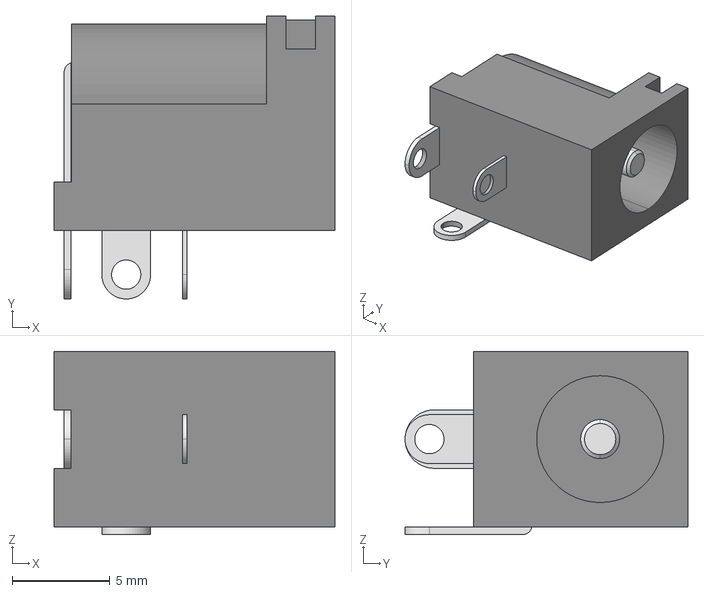
[picture p34: CAD file, 2017-10-12]
Proyecto/Analizador_de_espectro/STEP/PJ-002A.stp
14.4 x 14.5 x 9.40 mm
