Hojnadel/TD2_Altium/Proyecto/Datasheets/TFT 3.5/3.5inch_Arduino_ILI9481_IPS_V3.0/Arduino Demo_UNO&Mega2560/Install libraries/TouchScreen/README.txt

This is the 4-wire resistive touch screen firmware for Arduino. Works with all Arduinos and the Mega

To install, click DOWNLOAD SOURCE in the top right corner, and rename the uncompressed folder "TouchScreen". See our tutorial at http://www.ladyada.net/library/arduino/libraries.html on Arduino Library installation
