Hojnadel/TD2_Altium/Proyecto/Analizador_de_espectro/Analizador_de_espectro.pdf

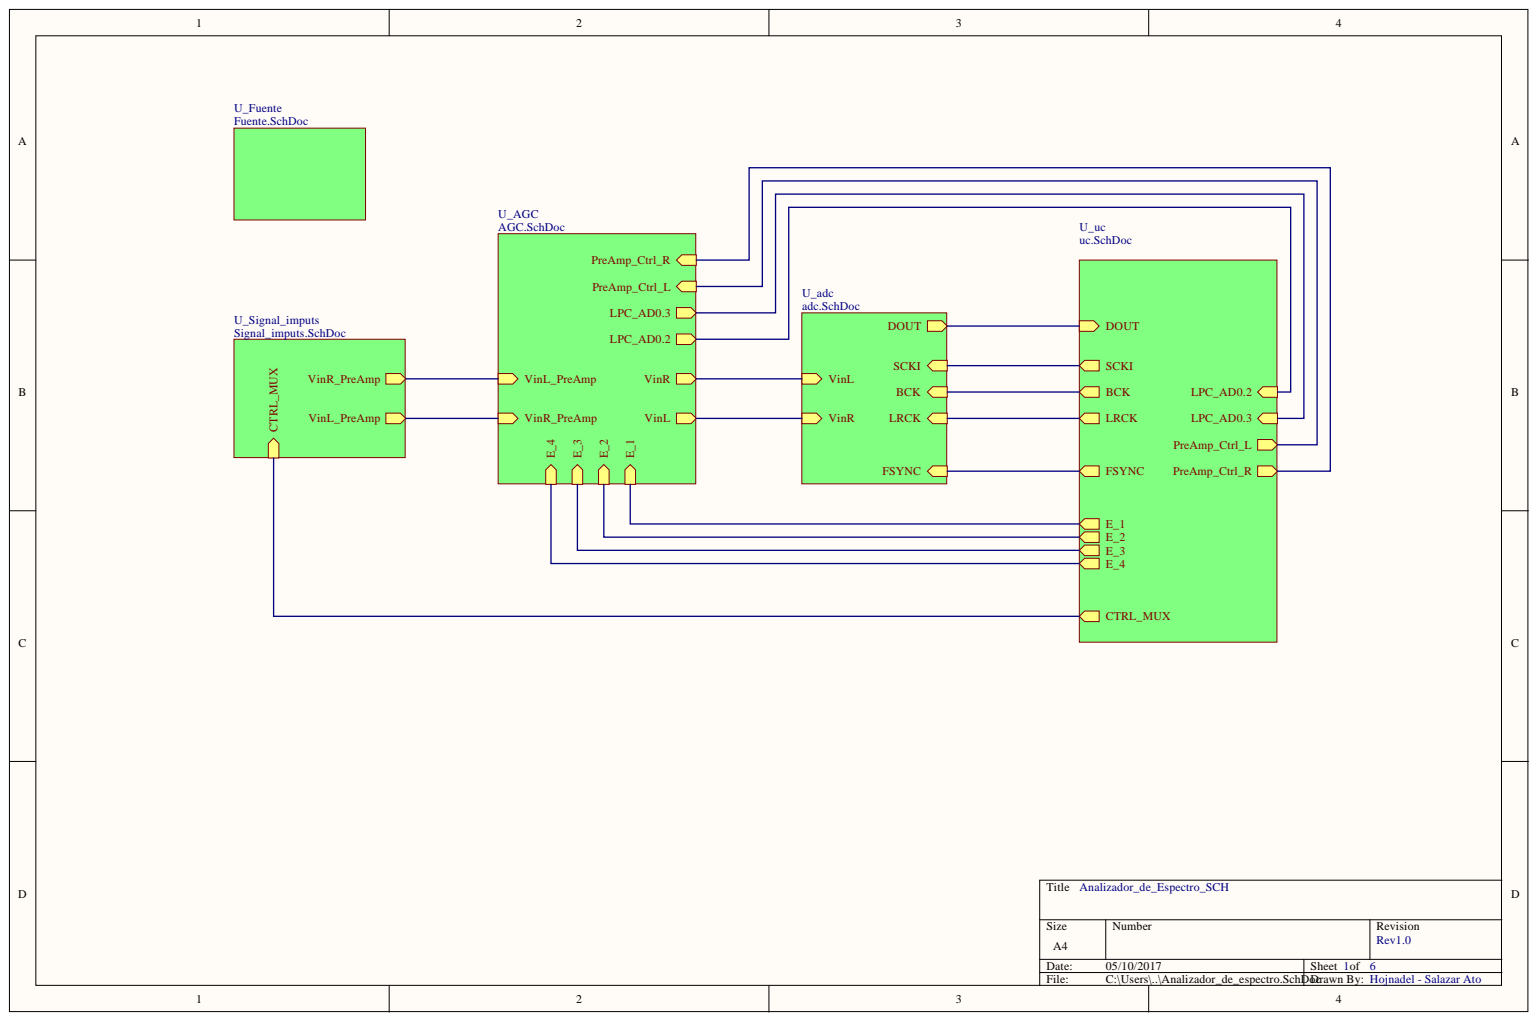
[picture p50: page 1]

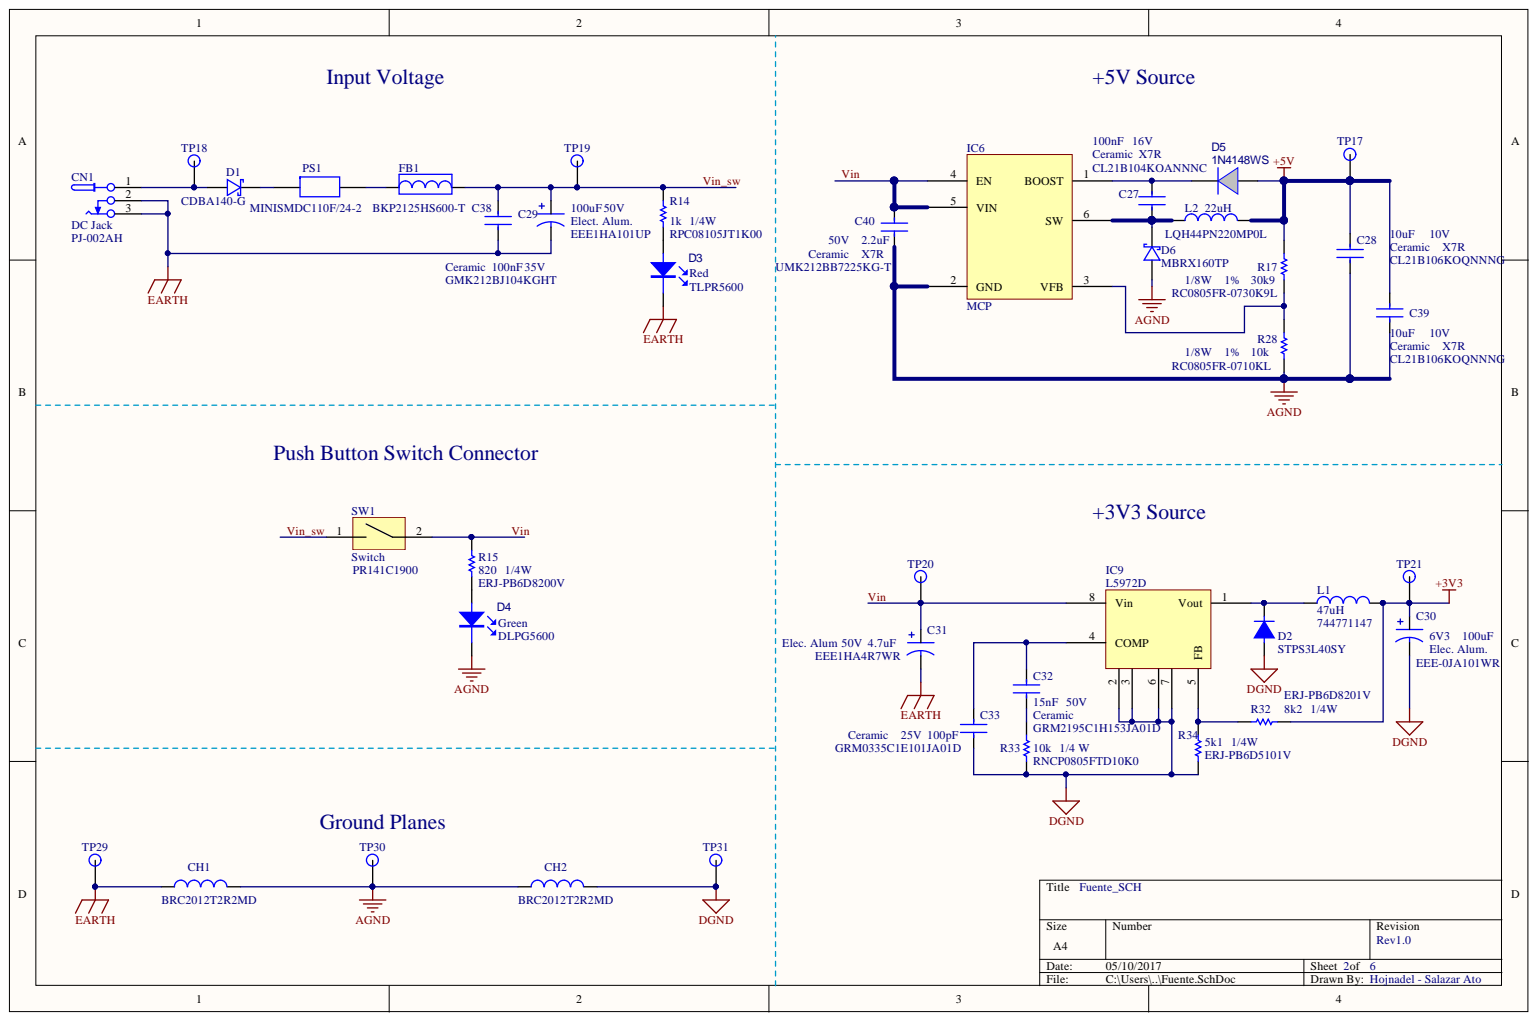
[picture p51: page 2]

Push Button Switch Connector

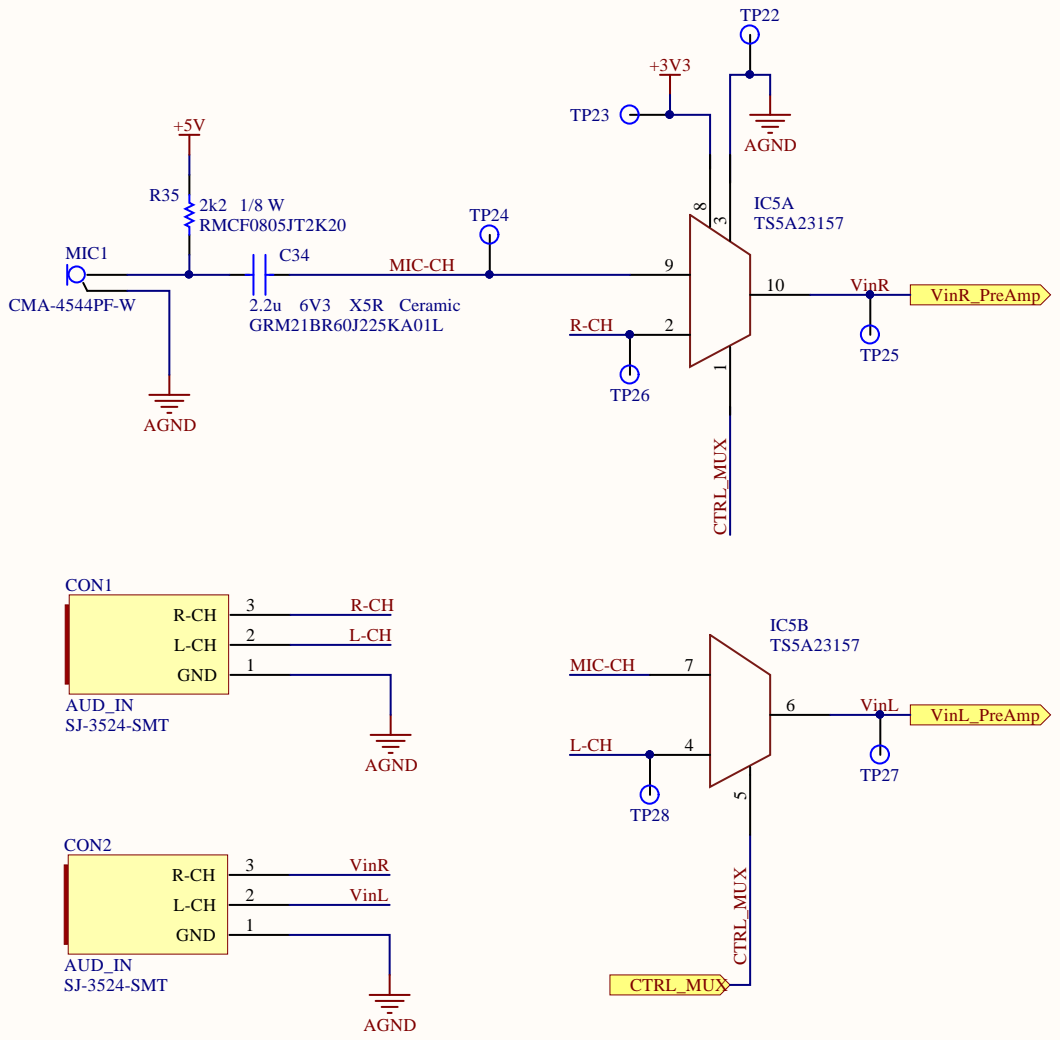
[picture p52: page 3]

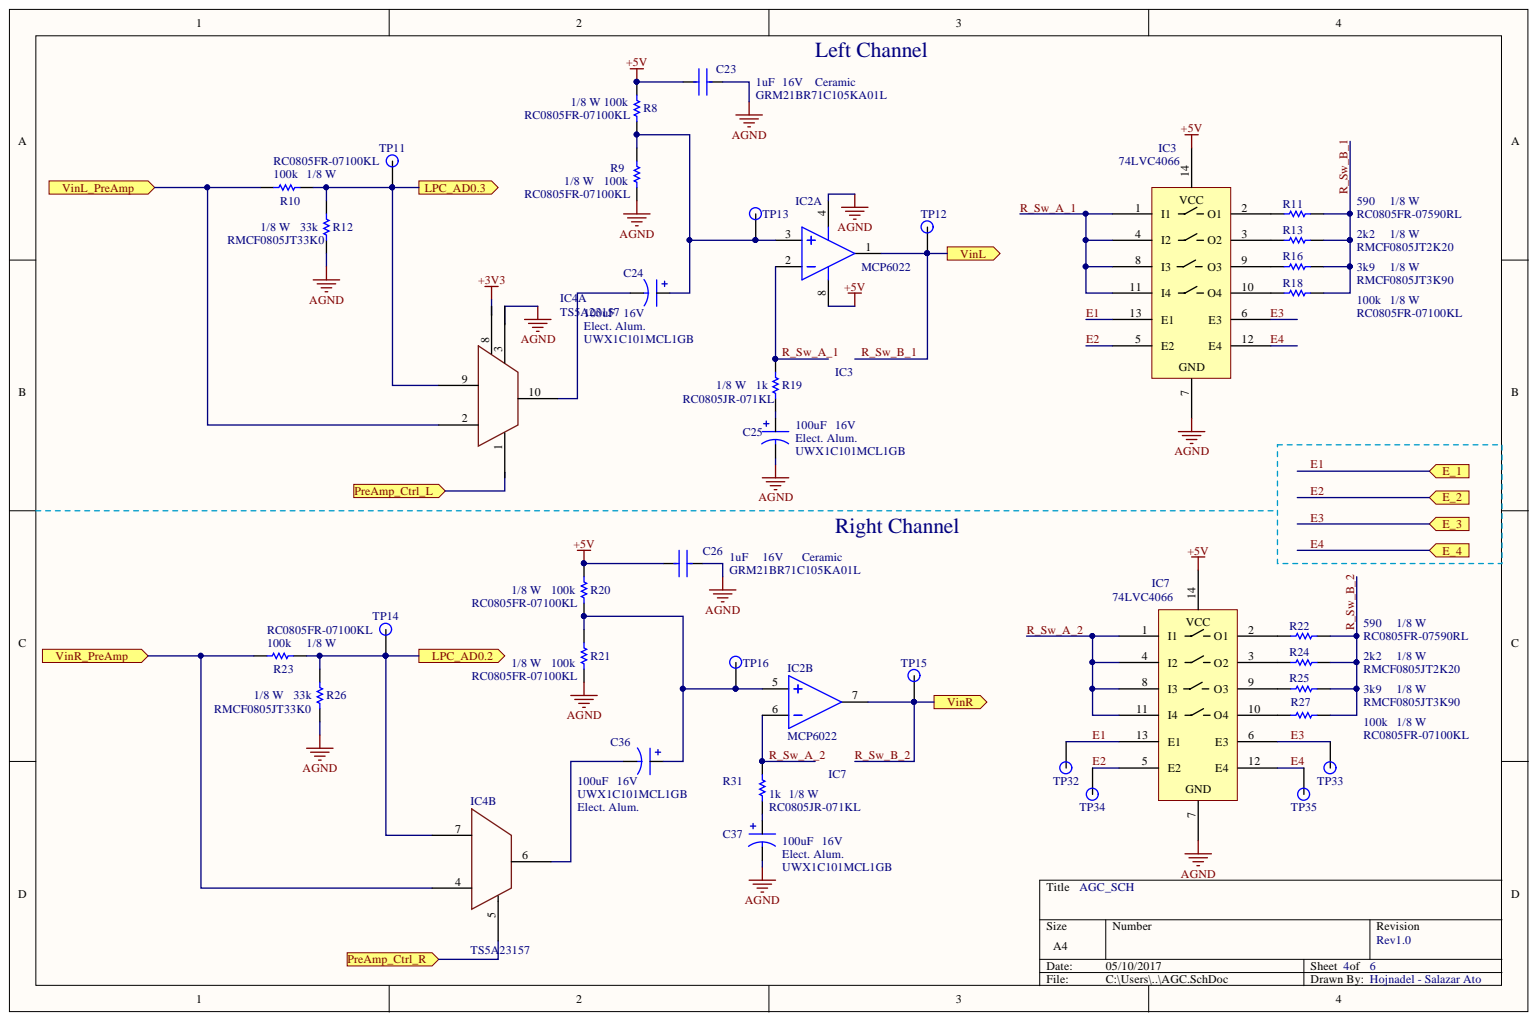
[picture p53: page 4]

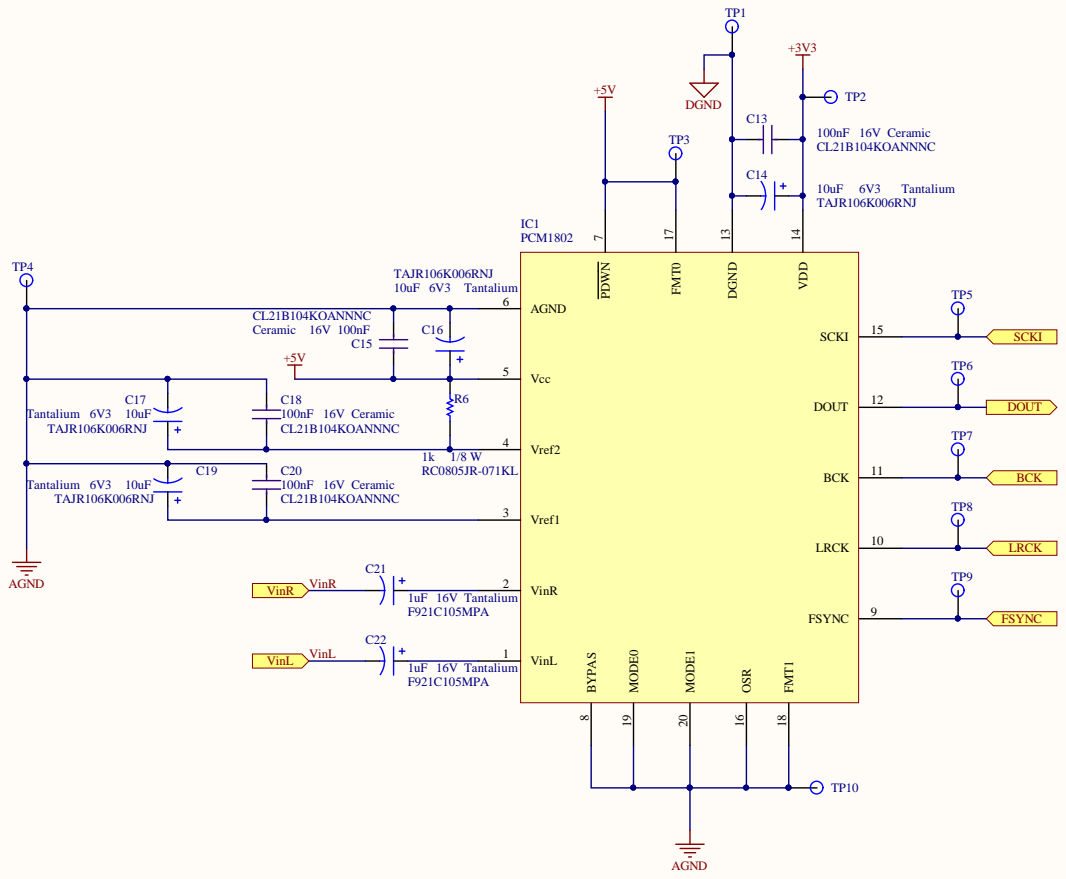
[picture p54: page 5]

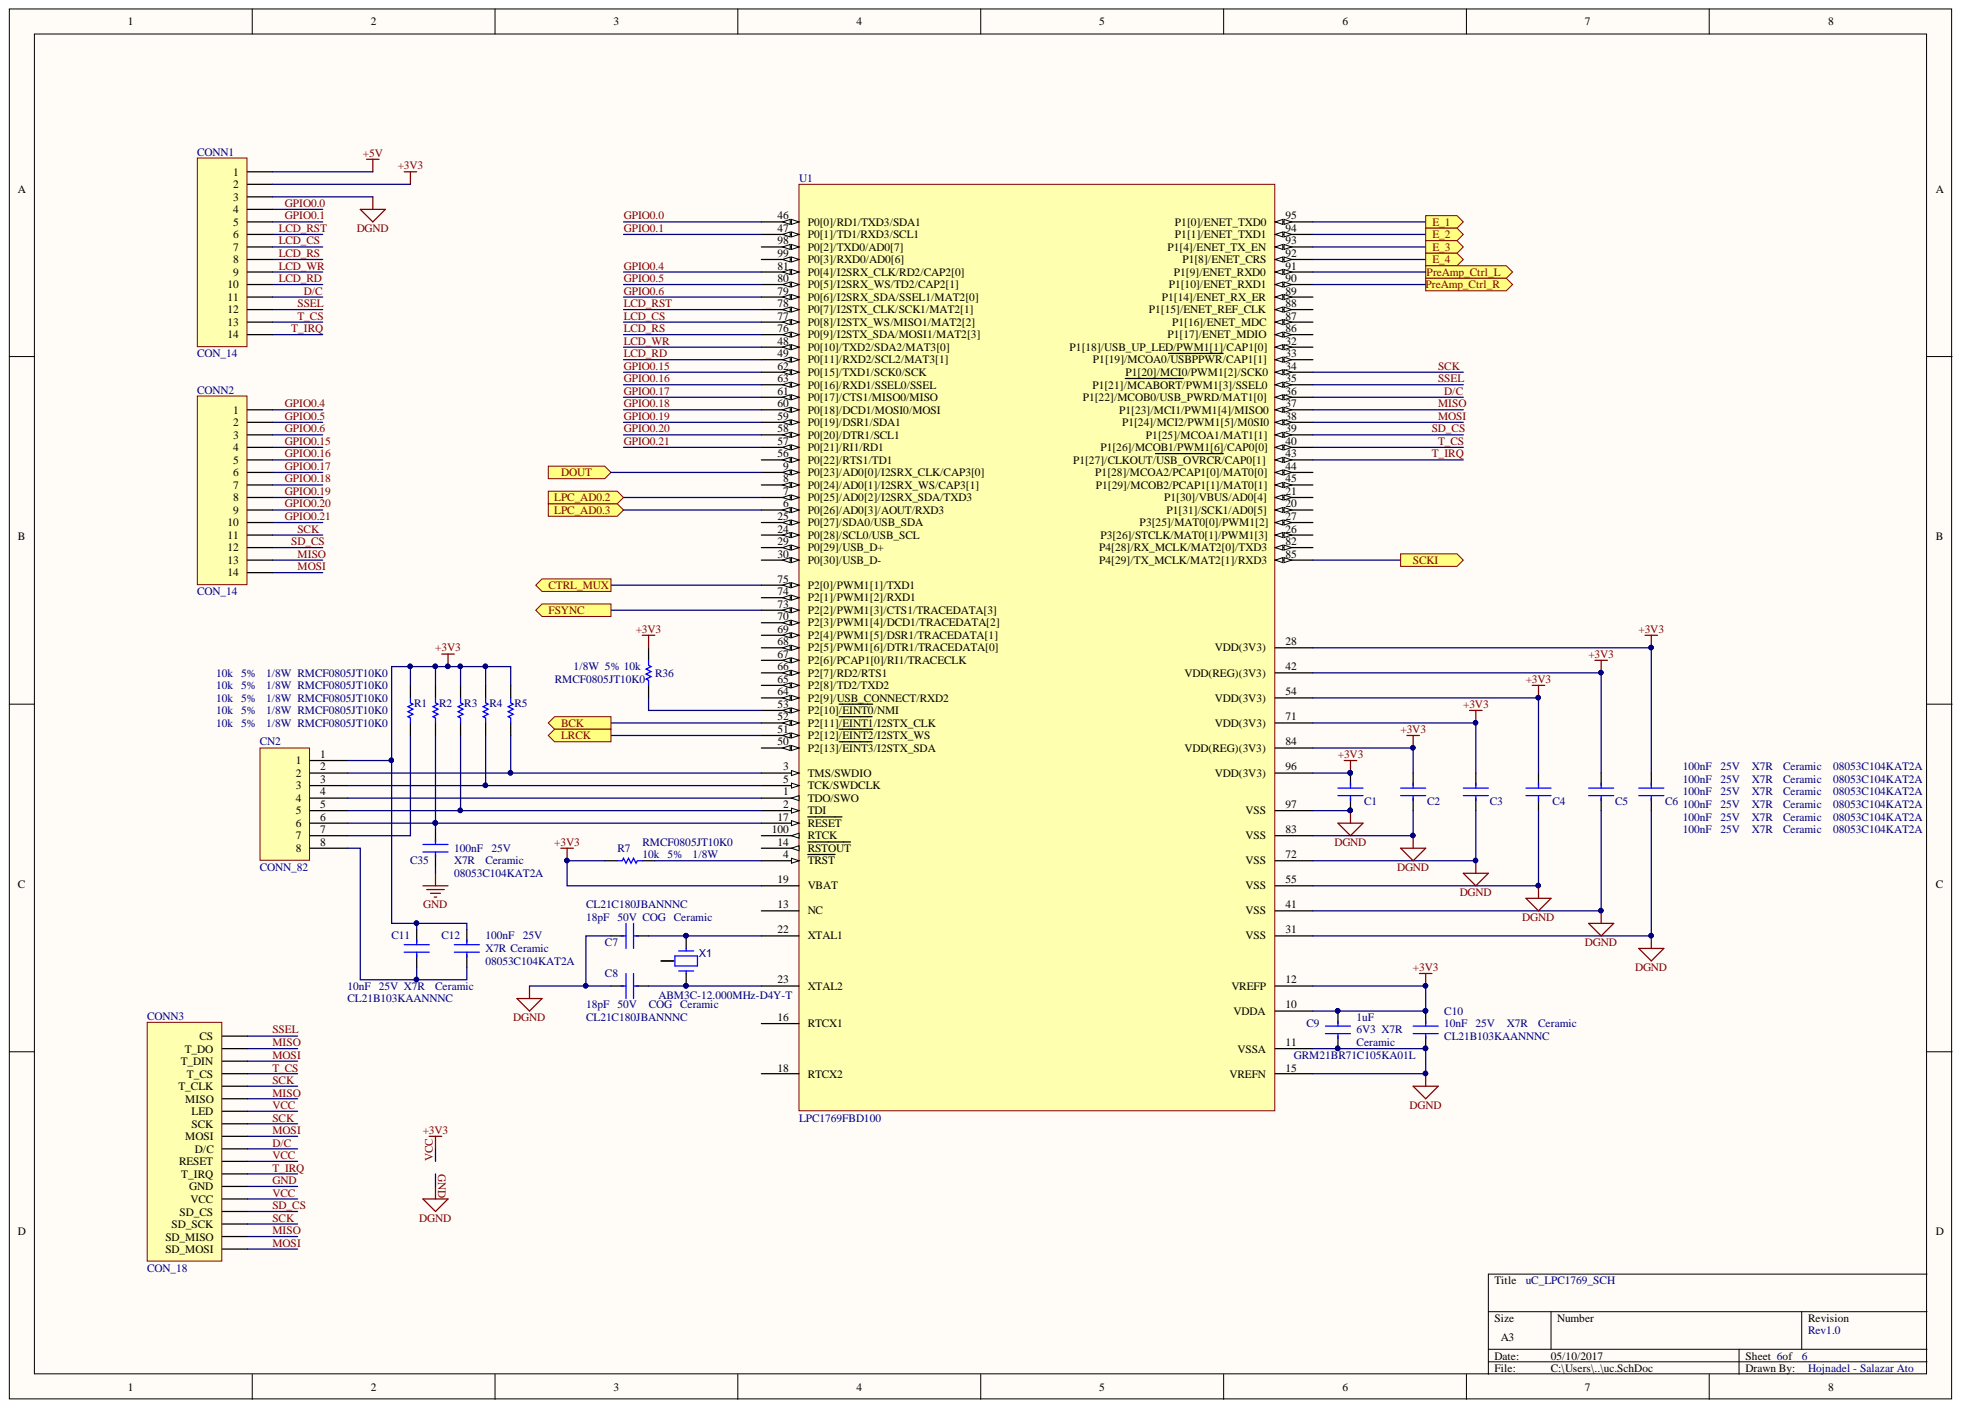
[picture p55: page 6]

7 | +3V

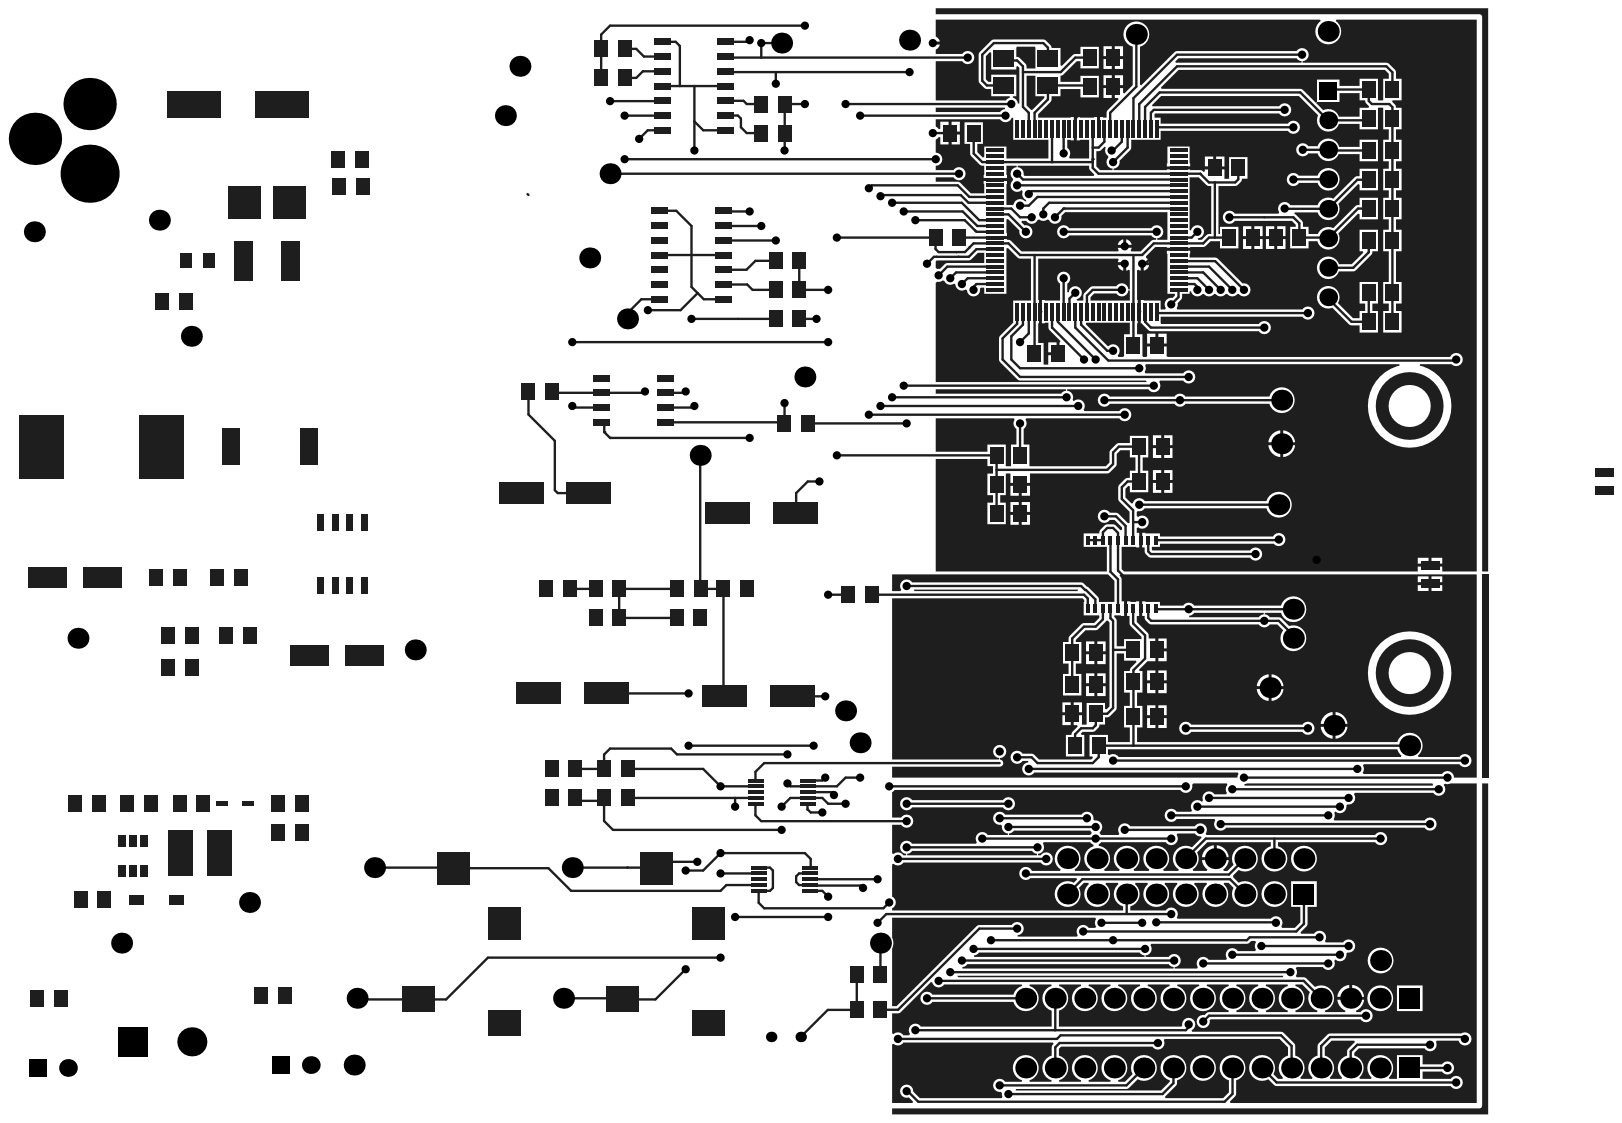
[picture p56: page 7]
