Hojnadel/TD2_Altium/Proyecto/Draft_levantamiento_amplificacion.asc

C1: cap; 22µ
C2: cap; 22µ
R1: res; 100k
R2: res; 100k
R3: res; 100k
R4: res; 100
R5: res; 100k
R6: res; 1k
R7: res; 9k
U1: opamp
U2: opamp
V1: voltage; SINE(0 100m 100)
V2: battery; 5
Named nets: 0
.include opamp.sub
.tran 0 20m 1m 10u
