Hojnadel/TD2_Altium/(list of files, drawings)

Other design files:
Proyecto/_Fuente Td2/Fuente/Fuente.PcbLib
Proyecto/_Fuente Td2/Fuente/Fuente.PrjPcb
Proyecto/_Fuente Td2/Fuente/Fuente.SchDoc
Proyecto/Analizador_de_espectro/adc.SchDoc
Proyecto/Analizador_de_espectro/AGC.SchDoc
Proyecto/Analizador_de_espectro/Analizador_de_espectro.PcbDoc
Proyecto/Analizador_de_espectro/Analizador_de_espectro.PrjPcb
Proyecto/Analizador_de_espectro/Analizador_de_espectro.SchDoc
Proyecto/Analizador_de_espectro/BACK_UP_02_10_Analizador_de_espectro.PcbDoc
Proyecto/Analizador_de_espectro/BACK_UP_04_10_Analizador_de_espectro.PcbDoc
Proyecto/Analizador_de_espectro/BACK_UP_05_10_Analizador_de_espectro.PcbDoc
Proyecto/Analizador_de_espectro/Conectores_pines.PcbLib
Proyecto/Analizador_de_espectro/D_M6959X25N.PcbLib
Proyecto/Analizador_de_espectro/DPAK.PcbLib
Proyecto/Analizador_de_espectro/Fuente.PcbLib
Proyecto/Analizador_de_espectro/Fuente.SchDoc
Proyecto/Analizador_de_espectro/INDP128122X60N.PcbLib
Proyecto/Analizador_de_espectro/LituLib.SchLib
Proyecto/Analizador_de_espectro/QFN1279600-8N.PcbLib
Proyecto/Analizador_de_espectro/Signal_imputs.SchDoc
Proyecto/Analizador_de_espectro/SOP65P780X200-20N.PcbLib
Proyecto/Analizador_de_espectro/TDII_Lib.PcbLib
Proyecto/Analizador_de_espectro/TDII_Lib_V2.SchLib
Proyecto/Analizador_de_espectro/uc.SchDoc
Proyecto/Libreria de footprints de Altium/Miscellaneous Connectors/Miscellaneous Connectors.PcbLib
Proyecto/Libreria de footprints de Altium/Miscellaneous Connectors/Miscellaneous Connectors.SchLib
Proyecto/Libreria de footprints de Altium/Miscellaneous Devices/Miscellaneous Devices.PcbLib
Proyecto/Libreria de footprints de Altium/Miscellaneous Devices/Miscellaneous Devices.SchLib
Proyecto/Libreria de footprints descargada IFS_Altium/IFS_Altium/Capacitors.PcbLib
Proyecto/Libreria de footprints descargada IFS_Altium/IFS_Altium/Capacitors.SchLib
Proyecto/Libreria de footprints descargada IFS_Altium/IFS_Altium/Connectors.PcbLib
Proyecto/Libreria de footprints descargada IFS_Altium/IFS_Altium/Connectors.SchLib
Proyecto/Libreria de footprints descargada IFS_Altium/IFS_Altium/Diodes.PcbLib
Proyecto/Libreria de footprints descargada IFS_Altium/IFS_Altium/Displays.PcbLib
Proyecto/Libreria de footprints descargada IFS_Altium/IFS_Altium/IFS_Altium.SchLib
Proyecto/Libreria de footprints descargada IFS_Altium/IFS_Altium/LQFP.PcbLib
Proyecto/Libreria de footprints descargada IFS_Altium/IFS_Altium/Microcontrollers.SchLib
Proyecto/Libreria de footprints descargada IFS_Altium/IFS_Altium/PDIP.PcbLib
Proyecto/Libreria de footprints descargada IFS_Altium/IFS_Altium/QFN.PcbLib
Proyecto/Libreria de footprints descargada IFS_Altium/IFS_Altium/Resistors.PcbLib
Proyecto/Libreria de footprints descargada IFS_Altium/IFS_Altium/Resistors.SchLib
Proyecto/Libreria de footprints descargada IFS_Altium/IFS_Altium/SOT.PcbLib
Proyecto/Libreria de footprints descargada IFS_Altium/IFS_Altium/Switches.PcbLib
Proyecto/Libreria de footprints descargada IFS_Altium/IFS_Altium/TO Packages.PcbLib
Proyecto/Libreria de footprints descargada IFS_Altium/IFS_Altium/TQFP.PcbLib
Proyecto/Libreria de footprints descargada IFS_Altium/IFS_Altium/TSSOP.PcbLib
Proyecto/Libreria de footprints descargada IFS_Altium/IFS_Altium/XTALs.PcbLib
Proyecto/PCB_Project/PCB1.PcbDoc
Proyecto/PCB_Project/PCB_Project.PrjPcb
Proyecto/PCB_Project/Sheet1.SchDoc
Proyecto/PCB_Project/Sheet2.SchDoc
