Hojnadel/TD2_Altium/TP1/TP1/src/main.c

/* Copyright 2016, Pablo Ridolfi
 * All rights reserved.
 *
 * This file is part of Workspace.
 *
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
 * 3. Neither the name of the copyright holder nor the names of its
 *    contributors may be used to endorse or promote products derived from this
 *    software without specific prior written permission.
 *
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
 */
 
/** @brief This is a simple blink example.
 */

/** \addtogroup blink Bare-metal blink example
 ** @{ */

/*==================[inclusions]=============================================*/

#include "main.h"
#include "board.h"

/*==================[macros and definitions]=================================*/

/*==================[internal data declaration]==============================*/

/*==================[internal functions declaration]=========================*/


int divisor=1;					// Frequency divisor
int change_time=CHANGE_FREQ;	// Frequency at which the divisor change


/** @} doxygen end group definition */

/** @brief hardware initialization function
 *	@return none
 */
static void initHardware(void);

/** @brief delay function
 * @param t desired milliseconds to wait
 */
static void pausems(uint32_t t);

/*==================[internal data definition]===============================*/

/** @brief used for delay counter */
static uint32_t pausems_count;

/*==================[external data definition]===============================*/

/*==================[internal functions definition]==========================*/

static void initHardware(void)
{
	Board_Init();
	SystemCoreClockUpdate();
	SysTick_Config(SystemCoreClock / 1000);
}

static void pausems(uint32_t t)
{
	pausems_count = t;
	while (pausems_count != 0) {
		__WFI();
	}
}

/*==================[external functions definition]==========================*/

void SysTick_Handler(void)
{
	if(pausems_count > 0) pausems_count--;

	if(!change_time--){						//If passed CHANGE_FREQ sec
		change_time=CHANGE_FREQ;
		(divisor==10)?divisor=1:divisor++;	//If the period divisor is 10, reset it; otherwise, increase it
	}
}




int main(void)
{
	initHardware();

	while (1)
	{
		Board_LED_Toggle(LED);
		pausems(DELAY_MS/divisor);
	}
}


/*==================[end of file]============================================*/
