Hojnadel/TD2_Altium/Proyecto/Codigo a reciclar/eqh/SD/sd_header.h

/*
 * sd_header.h
 *
 *  Created on: 12 de dic. de 2016
 *      Author: agustin
 */

#ifndef SD_HEADER_H_
#define SD_HEADER_H_


#include <header.h>


// ********* FUNCIONES ********** //
	#if USE_SD


	#endif
// ****************************** //


// ***************** DEFINES ***************** //
	#if USE_SD



	#endif


// ******************************************* //


// *************** ESTRUCTURAS *************** //
	#if USE_SD



	#endif
// ******************************************* //


// ************* VARIABLES GLOBALES ************* //
	#if USE_SD



	#endif
// ********************************************** //


// ************* HEADERS ************* //

//	#include "integer.h"	/* Basic integer types */
//	#include "ffconf.h"		/* FatFs configuration options */
	#include "sd_init.h"
	#include "stdlib.h"

// ****************************************** //



#endif /* SD_HEADER_H_ */
