Hojnadel/TD2_Altium/Proyecto/Codigo a reciclar/eqh/adc_dac/adc_dac_func.h

/*
 * adc_dac_func.h
 *
 *  Created on: 31 de oct. de 2016
 *      Author: agustin
 */



#ifndef ADC_DAC_FUNC_H_
#define ADC_DAC_FUNC_H_


#include "header.h"



#if (USE_DMA)

	uint32_t set_data (uint32_t data);

#endif



#endif /* ADC_DAC_FUNC_H_ */
