Hojnadel/TD2_Altium/TP2/TP2_RTOS_v4/inc/H-RGB.h

#ifndef _RGB_H_
#define _RGB_H_

#define		AZUL			1
#define		VERDE			2
#define		CIAN			3
#define		ROJO			4
#define		VIOLETA			5
#define		AMARILLO		6
#define		BLANCO			7

#define		APAGADO			0
#define 	ASCENDENTE		1
#define 	DESCENDENTE		2

#define 	T_LED			1000


void secuencia_LED(uint8_t);


#endif
