Hojnadel/TD2_Altium/Proyecto/Datasheets/TFT 3.5/3.5inch_Arduino_ILI9481_IPS_V3.0/STM32 Demo_STM32F103RCT6/STM32综合测试程序ILI9481_IO模拟/USER/main.c

#include "delay.h"
#include "sys.h"
#include "lcd.h"
#include "touch.h"
#include "gui.h"
#include "test.h"
//////////////////////////////////////////////////////////////////////////////////	 
//本程序只供学习使用，未经作者许可，不得用于其它任何用途
//测试硬件：单片机STM32F103RBT6,正点原子MiniSTM32开发板,主频72MHZ
//QDtech-TFT液晶驱动 for STM32 IO模拟
//xiao冯@ShenZhen QDtech co.,LTD
//公司网站:www.qdtech.net
//淘宝网站：http://qdtech.taobao.com
//我司提供技术支持，任何技术问题欢迎随时交流学习
//固话(传真) :+86 0755-23594567 
//手机:15989313508（冯工） 
//邮箱:QDtech2008@gmail.com 
//Skype:QDtech2008
//技术交流QQ群:324828016
//创建日期:2013/5/13
//版本：V1.1
//版权所有，盗版必究。
//Copyright(C) 深圳市全动电子技术有限公司 2009-2019
//All rights reserved
/****************************************************************************************************
//=========================================电源接线================================================//
//5V接DC 5V电源
//GND接地
//=======================================液晶屏数据线接线==========================================//
//本模块默认数据总线类型为8位并行模式
//8位模式接线：8位模式ILI9481模块接低8位总线，即:
//液晶屏LCD_D0对应单片机PB0
//液晶屏LCD_D1对应单片机PB1
//液晶屏LCD_D2对应单片机PB2
//液晶屏LCD_D3对应单片机PB3
//液晶屏LCD_D4对应单片机PB4
//液晶屏LCD_D5对应单片机PB5
//液晶屏LCD_D6对应单片机PB6
//液晶屏LCD_D7对应单片机PB7
//=======================================液晶屏控制线接线==========================================//
//LCD_RST	接PC5	//复位信号
//LCD_CS	接PC9	//片选信号
//LCD_RS	接PC8	//寄存器/数据选择信号
//LCD_WR	接PC7	//写信号
//LCD_RD	接PC6	//读信号
//=========================================触摸屏触接线=========================================//
//本模块触摸测试需连接外部XPT2046触摸采样芯片，所以本程序不进行触摸测试。
//不使用触摸或者模块本身不带触摸，则可不连接
**************************************************************************************************/	
#define CAL_X 0x00378F66UL
#define CAL_Y 0x03C34155UL
#define CAL_S 0x000EF13FUL
u32 touch_x_left,touch_x_right,touch_y_top,touch_y_bottom,disp_x_size,disp_y_size;
void test_tp(void)
{
	
		touch_x_left			= (CAL_X>>14) & 0x3FFF;
	touch_x_right			= CAL_X & 0x3FFF;
	touch_y_top				= (CAL_Y>>14) & 0x3FFF;
	touch_y_bottom			= CAL_Y & 0x3FFF;
	disp_x_size				= (CAL_S>>12) & 0x0FFF;
	disp_y_size				= CAL_S & 0x0FFF;

}
int main(void)
{	u16 i=0;	
	SystemInit();//初始化RCC 设置系统主频为72MHZ
	delay_init(72);	     //延时初始化
	LCD_Init();	   //液晶屏初始化
//test_tp();
	while(1)
	{	
		main_test(); 		//测试主界面
		Test_Color();  		//简单刷屏填充测试
		Test_FillRec();		//GUI矩形绘图测试
		Test_Circle(); 		//GUI画圆测试
		English_Font_test();//英文字体示例测试
		Chinese_Font_test();//中文字体示例测试
		Pic_test();			//图片显示示例测试
		//Touch_Test();		//触摸屏手写测试  
		
	}				  
	
 }
