Hojnadel/TD2_Altium/(commit log)

2017-08-19 Prueba
    Prueba
    [128x16bit_SPI_EEPROM.SchDoc, 1V8&1V2_DCDC_Convertor.SchDoc, 1WB_DS2406_EPROM.SchDoc, 256Kx16_SRAM.SchDoc, 3-Axis_Accelerometer.SchDoc, 3V3_DCDC_Convertor.SchDoc, 3V3_Low_Dropout_ Regulator.SchDoc, 512KBits_I2C_EEPROM.SchDoc]
2017-08-19 Segundo intento
    [128x16bit_SPI_EEPROM.SchDoc, 1V8&1V2_DCDC_Convertor.SchDoc, 1WB_DS2406_EPROM.SchDoc, 256Kx16_SRAM.SchDoc, 3-Axis_Accelerometer.SchDoc, 3V3_DCDC_Convertor.SchDoc, 3V3_Low_Dropout_ Regulator.SchDoc, 512KBits_I2C_EEPROM.SchDoc]
2017-08-31 prueba 3
    Para ver si lo ve el tucu
2017-08-31 Borrado de pruebas
2017-08-31 Atualización del proyecto
    Copiado
    [Analizador_de_espectro.PrjPcb, Analizador_de_espectro.SchDoc, Fuente.SchDoc, TDII_Lib.PcbLib, adc.SchDoc]
2017-08-31 Eliminacion archivo uplicado
    [Analizador_de_espectro.SchDoc]
2017-08-31 Librería
    [TDII_Lib_V2.SchLib]
2017-08-31 Subida seria 1
    [Analizador_de_espectro.PrjPcb, Analizador_de_espectro.SchDoc, uc.SchDoc]
2017-08-31 Subida desde 0
    [Analizador_de_espectro.PrjPcb, Analizador_de_espectro.SchDoc, Fuente.SchDoc, TDII_Lib.PcbLib, TDII_Lib_V2.SchLib, adc.SchDoc, uc.SchDoc]
2017-08-31 Primer pull serio
    Se suben todos los archivos bien
    [Analizador_de_espectro.PrjPcb, Conectores.SchDoc, Fuente.SchDoc, LituLib.SchLib, TDII_Lib_V2.SchLib, adc.SchDoc]
2017-09-01 ADC y Fuente sch
    [Fuente.SchDoc, adc.SchDoc]
2017-09-01 uc y pines
    [uc.SchDoc]
2017-09-02 Final de clase TD2 1/9
    [Analizador_de_espectro.SchDoc, Fuente.SchDoc, TDII_Lib_V2.SchLib, adc.SchDoc, td2_cpu_r00.SchDoc, uc.SchDoc]
2017-09-03 Cambios sch
    [Conectores.SchDoc, Fuente.SchDoc, Signal_imputs.SchDoc, adc.SchDoc, uc.SchDoc]
2017-09-04 4/9
    No se qué cambios son
    [Analizador_de_espectro.PrjPcb]
2017-09-05 Fuente switching
    [Analizador_de_espectro.PrjPcb, Fuente.SchDoc, TDII_Lib_V2.SchLib]
2017-09-05 Componentes
    Agregue en la libreria los test poin y un conector
    [Fuente.SchDoc, TDII_Lib_V2.SchLib, uc.SchDoc]
2017-09-07 Cambios lib
    [AGC.SchDoc, Analizador_de_espectro.SchDoc, Fuente.SchDoc, Signal_imputs.SchDoc, TDII_Lib_V2.SchLib, adc.SchDoc, uc.SchDoc]
2017-09-08 Cambios lib 2
    [AGC.SchDoc, LituLib.SchLib, TDII_Lib_V2.SchLib]
2017-09-08 Cambios Sch AGC
    [AGC.SchDoc, Signal_imputs.SchDoc]
2017-09-08 Cambios Sch Analizador de espectro
    [AGC.SchDoc, Analizador_de_espectro.SchDoc, Signal_imputs.SchDoc, uc.SchDoc]
2017-09-08 Cambios uC
    [Analizador_de_espectro.SchDoc, uc.SchDoc]
2017-09-08 Cambios Sch conecores TFT
    [Analizador_de_espectro.SchDoc, TDII_Lib_V2.SchLib, uc.SchDoc]
2017-09-09 Terminado 1
    [AGC.SchDoc, Analizador_de_espectro.PrjPcb, Analizador_de_espectro.SchDoc, Fuente.SchDoc, LituLib.SchLib, Signal_imputs.SchDoc, TDII_Lib_V2.SchLib, adc.SchDoc]
2017-09-10 SCH Terminado 1
    [AGC.SchDoc, Analizador_de_espectro.PrjPcb, Analizador_de_espectro.SchDoc, Analizador_de_espectro.csv, Fuente.SchDoc, Signal_imputs.SchDoc, TDII_Lib_V2.SchLib, adc.SchDoc]
2017-09-14 Rail2Rail - InstAmp - Negative VOltage
2017-09-14 op espejados
    [AGC.SchDoc]
2017-09-18 Pruba lib_pcb
    [Analizador_de_espectro.PrjPcb, TDII_Lib_t.PcbLib]
2017-09-18 algunos cambios
    [Analizador_de_espectro.PrjPcb, DPAK.PcbLib, TDII_Lib.PcbLib, TDII_Lib_t.PcbLib]
2017-09-22 Lib footprints
    [AGC.SchDoc, Analizador_de_espectro.PrjPcb, D_M6959X25N.PcbLib, Fuente.SchDoc, SOP65P780X200-20N.PcbLib, Signal_imputs.SchDoc, TDII_Lib.PcbLib, adc.SchDoc]
2017-09-22 Mas footprints
    [Fuente.SchDoc, INDP128122X60N.PcbLib, Signal_imputs.SchDoc, TDII_Lib.PcbLib]
2017-09-24 lib y sch
    [AGC.SchDoc, Analizador_de_espectro.PrjPcb, Fuente.SchDoc, TDII_Lib.PcbLib, TDII_Lib_V2.SchLib, adc.SchDoc, uc.SchDoc]
2017-09-25 Empezando PCB
    [AGC.SchDoc, Analizador_de_espectro.PcbDoc, Analizador_de_espectro.PrjPcb, Analizador_de_espectro.csv, Fuente.SchDoc, PCB1.PcbDoc, PCB_Project.PrjPcb, Sheet1.SchDoc]
2017-09-27 cambio de anoche
    [Analizador_de_espectro.PcbDoc, Analizador_de_espectro.PrjPcb, Signal_imputs.SchDoc, TDII_Lib.PcbLib, TDII_Lib_V2.SchLib]
2017-09-27 Led y boton
    [Fuente.SchDoc, TDII_Lib_V2.SchLib]
2017-09-29 pequieños cambios
    [Analizador_de_espectro.PcbDoc, Analizador_de_espectro.PrjPcb, Fuente.SchDoc, PCB Layout Checklist.ods]
2017-09-29 Correccion algunos fp
    [Analizador_de_espectro.PcbDoc, TDII_Lib.PcbLib]
2017-10-02 funte de 5v
    [Analizador_de_espectro.PcbDoc, Fuente.PcbLib, Fuente.PrjPcb, Fuente.SchDoc, TDII_Lib_V2.SchLib, uc.SchDoc]
2017-10-03 Avanzada de PCB
    [Analizador_de_espectro.PcbDoc, Analizador_de_espectro.PrjPcb, BACK_UP_02_10_Analizador_de_espectro.PcbDoc, Fuente.PcbLib, Fuente.SchDoc, TDII_Lib_V2.SchLib, uc.SchDoc]
2017-10-05 Terminado 2
    [Analizador_de_espectro.PcbDoc, Analizador_de_espectro.PrjPcb, Analizador_de_espectro.csv, BACK_UP_05_10_Analizador_de_espectro.PcbDoc, uc.SchDoc]
2017-10-06 corte de placa
    [Analizador_de_espectro.PcbDoc, Analizador_de_espectro.PrjPcb, Conectores_pines.PcbLib, DPAK.PcbLib, QFN1279600-8N.PcbLib]
2018-05-11 Actualizacion de gastos
2018-05-19 Informe completo para SdR
2018-10-24 actualziacion de gastos
    actualziacion de gastos
2018-12-12 Proyecto_Persefone
    Proyecto Persefona antes de freertos
2018-12-16 Add files via upload
    Codigo de Persefone subido
    Tiene las siguientes cosas:
    Muestra a 44.1kHz
    Imprime en pantalla en ventanas de aprox. 4.4 kHz,, seleccionable con switch de placa
    Imprime el tipo de ventaneo que realiza y se puede elegir mediante switch de placa
    Ventaneo rectangular por default
2018-12-19 Actualizacion de freertos
    Se separó la tarea de lectura de teclado en leer y resolver teclado, sincrinizada por colas
2018-12-19 Create TD2_AE_19_12_1222.zip
    Proyecto andando:
    *Freertos con 3 tareas comunicadas por colas y semaforos
    *Novedad: se agregó la función de decrementar el span y volver a full span con los swtiches 3 y 4
2018-12-19 Create TD2_AE_19_12_1526.zip
    Version completa:
    Se agregó el indicador de frecunecia pico y amplitud máxima.
    Se vio un defecto en el que, al estar en una ventana que no sea rectangular, si se cambiaba el span, iba a figurar RECTANGULAR. No se sabe si eso ya estaba pasando en la versión anterior.
