Hojnadel/TD2_Altium/(notices)

Notices in the files:
Proyecto/Datasheets/TFT 3.5/3.5inch_Arduino_ILI9481_IPS_V3.0/C51 Demo_STC12LE5A60S2/C51综合测试程序_ILI9481(精简测试-适合ROM容量小单片机)/USER/main.c:
Copyright(C) ÉîÛÚÊÐÈ«¶¯µç×Ó¼¼ÊõÓÐÏÞ¹«Ë¾ 2009-2019
All rights reserved
